sinara-hw/DiPho/README.md

# DiPho

Digital photodiode with USB and Ethernet interfaces

## Design Files

Design files (schematics, PCB layouts, BOMs) can be found at [DiPho/Releases](https://github.com/sinara-hw/DiPho/releases).

## Wiki

More information can be found on the [wiki](https://github.com/sinara-hw/DiPho/wiki).
