sinara-hw/DiPho/DiPho_AFE/Project Outputs for DiPho_AFE/DiPho_AFE_BoM.xlsx

Designator | Quantity | Manufacturer Part Number | Comment | Footprint | Description
R13 | 1 | R0402_0R_JUMPER | 0 | RESC1005X40N | Resistor
R12 | 1 | R0402_324K_0.1%_0.063W_100PPM | 324k | RESC1005X40N | Resistor - 0.1%
R11 | 1 | R0402_32K4_0.1%_0.063W_25PPM | 32k4 | RESC1005X40N | Resistor - 0.1%
R10 | 1 | R0402_3K24_0.1%_0.0625W_100PPM | 3k24 | RESC1005X40N | Resistor - 0.1%
R9 | 1 | R0402_324R_0.1%_0.063W_100PPM | 324 | RESC1005X40N | Resistor - 0.1%
R8 | 1 | R0402_2K2_1%_0.0625W_100PPM | 2k2 | RESC1005X40N | Resistor - 1%
R7 | 1 | R0402_10K2_1%_0.0625W_100PPM | 10k2 | RESC1005X40N | Resistor - 1%
R6, R14 | 2 | R0402_10K_1%_0.0625W_100PPM | 10k | RESC1005X40N | Resistor - 1%
R5 | 1 | R0402_1K_1%_0.0625W_100PPM | 1k | RESC1005X40N | Resistor - 1%
R2, R4 | 2 | R0402_470R_1%_0.0625W_100PPM | 470 | RESC1005X40N | Resistor - 1%
R1, R3, R17, R18, R19 | 5 | R0402_10K_0.1%_0.063W_25PPM | 10k | RESC1005X35N | Resistor - 0.1%
L2 | 1 | BLM15HD601SN1D | 600R@100MHz | INDC1005X55N | Ferrite Bead
J1 | 1 | 52465-1671 | 52465-1671 | 524651671 | A Connector for Board - Board Connections with A 0.80 mm Pitch. (Molex)
IC8 | 1 | AD8541ARTZ-REEL7 | AD8541ARTZ-REEL7 | ADI-RJ-5_N | Single Channel RRIO Operational Amplifier, 1 MHz BW, 920 mV/us SR, Industrial, 5-pin SOT23 (RJ-5), Reel
IC6 | 1 | MAX4639EUE+T | MAX4639EUE+T | TSOP65P640X110-16L | MAX4639 Series SP4T 2.5V 3.5 Ohm Surface Mount Analog Switch - TSSOP-16
IC4 | 1 | AT24MAC402-MAHM-T | AT24MAC402-MAHM-T | FP-C04-21355-Q4B-MFG | IC EEPROM 2K I2C 1MHZ 8UDFN
IC3 | 1 | BD00HC5WEFJ-E2 | BD00HC5WEFJ-E2 | TSOP127P600X100_HS-9L | LDO Regulator Pos 0.8V to 4.5V 1.5A 8-Pin HTSOP-J EP T/R
IC1, IC2 | 2 | TLV9002SIRUGR | TLV9002SIRUGR | QFN50P150X200X40-10N | Rail-to-Rail Input/Output Operational Amplifier Dual 1.8V to 5.5V 10-Pin X2QFN T/R
D3 | 1 | VBPW34S | VBPW34S | SOT0P705X130-2M | IR-photodiode Photoelectric current: 45...55 uA Wavelength of max. photosensitivity: 940 nm
CLIP1, CLIP2, CLIP3, CLIP4 | 4 | S1721-46 | Clip 1 Pin | MSBOX_HARWIN_S1721-46 | Surface Mount Clip for PCB Screening Covers
C14 | 1 | CC0402_47PF_50V_5%_C0G | 47pF | CAPC1005X55N | Non-polarised capacitor
C13 | 1 | CC0402_470PF_50V_10%_X7R | 470pF | CAPC1005X55N | Non-polarised capacitor
C12 | 1 | CC0402_4.7NF_16V_10%_X7R | 4.7nF | CAPC1005X55N | Non-polarised capacitor
C11 | 1 | CC0402_47NF_25V_10%_X7R | 47nF | CAPC1005X55N | Non-polarised capacitor
C10, C16 | 2 | CC0603_4.7UF_16V_10%_X5R | 4.7uF | CAPC1709X95N | Non-polarised capacitor
C7, C8 | 2 | CC0805_10UF_10V_10%_X7R | 10uF | CAPC2012X135N | Non-polarised capacitor
C4 | 1 | CC0402_1NF_50V_10%_X7R | 1nF | CAPC1005X55N | Non-polarised capacitor
C3, C5, C6, C15, C17, C18 | 6 | CC0402_100NF_16V_10%_X7R | 100nF | CAPC1005X55N | Non-polarised capacitor
C2 | 1 | CC0402_680NF_10V_10%_X5R | 680nF | CAPC1005X55N | Non-polarised capacitor
C1 | 1 | CC0402_10NF_16V_10%_X7R | 10nF | CAPC1005X55N | Non-polarised capacitor
