sinara-hw/DiPho/DiPho_digital/Project Outputs for DiPho_digital/DiPho_digital_BoM.xlsx

Designator | Manufacturer Part Number | Quantity | Footprint | Comment | Description
C1, C11 | CC0402_10NF_16V_10%_X7R | 2 | CAPC1005X55N | 10nF | Non-polarised capacitor
C2, C3, C4, C13, C14, C15, C18, C19, C23, C26, C27 | CC0402_100NF_16V_10%_X7R | 11 | CAPC1005X55N | 100nF | Non-polarised capacitor
C5, C6 | CC0603_1UF_16V_10%_X7R | 2 | CAPC1608X87N | 1uF | Non-polarised capacitor
C7, C8, C9, C12 | CC0603_4.7UF_16V_10%_X5R | 4 | CAPC1709X95N | 4.7uF | Non-polarised capacitor
C10 | CC0402_1UF_16V_10%_X5R | 1 | CAPC1005X55N | 1uF | Non-polarised capacitor
C16 | CC0603_10UF_10V_10%_X5R | 1 | CAPC1608X80N | 10uF | Non-polarised capacitor
C17 | GRM21BR6YA106KE43 | 1 | CAPC2012X145N | 10uF | Non-polarised capacitor
C20, C21 | CC0805_220NF_100V_10%_X7R | 2 | CAPC2012X135N | 220nF | Non-polarised capacitor
C22, C24, C25 | CC0402_2.2UF_16V_10% | 3 | CAPC1005X55N | 2.2uF | Non-polarised capacitor
D1 | BZX84C7V5 | 1 | SOT95P240X130-3N | BZX84C7V5 | Diode Zener Anode Pin 1 Cathode Pin 3 (Pas de pin 2)
D2 | BAT54HT1G | 1 | SOD2513X100N | BAT54HT1G | Schottky Diode
D3 | DRTR5V0U4S-7 | 1 | SOT65P210X110-6N | DRTR5V0U4S-7 | Integrated Quad Ultra-Low Capacitance ESD Protection
D4, D5 | ESD7241N2T5G | 2 | DFN65P100X40-2N | ESD7241N2T5G | Ultra-Low Capacitance ESD Protection Ultra-Low Capacitance ESD Protection
IC1 | STM32F103T8U6 | 1 | STM-VFQFPN36_L | STM32F103T8U6 | ARM Cortex-M3 32-bit MCU, 64 KB Flash, 20 KB Internal RAM, 26 I/Os, 36-pin VFQFPN, -40 to 85 degC, Tray
IC2 | MCP47CMB02-E/MG | 1 | QFN127P600-8N | MCP47CMB02-E/MG | DAC 2-CH Resistor-String 8-bit 16-Pin QFN EP Tube
IC3 | TLV76750DRVR | 1 | SON65P200X80_HS-7N | TLV76750DRVR | Precision Linear Voltage Regulator Positive 5V 1A 6-Pin WSON T/R
IC4 | NCP115ASN330T2G | 1 | SOT95P275X110-5N | NCP115ASN330T2G | LDO Regulator, 300 mA, Low Iq, High PSRR, High Accuracy 3.3V, TSOP5, Active Discharge, Normal Vout Slew-Rate
IC5 | NCN26010XMNTXG | 1 | QFN40P400X400X100_HS-33N | NCN26010XMNTXG | Ethernet Controller, 10 Mb/s, Single-Pair, MAC + PHY, 802.3cg, 10BASE−T1S Compliant
J1 | 0733660062 | 1 | 73366-0062 | 0733660062 | Conn MCX F 50Ohm Solder ST Thru-Hole Gold T/R
J2 | 5022370517 | 1 | 502237-0517 | 5022370517 | Conn Mini USB Type B RCP 5 POS 0.8mm Solder ST Thru-Hole 5 Terminal 1 Port USB 2.0 Tray
J3 | 53307-1671 | 1 | 533071671 | 53307-1671 | 0.80mm Pitch Header Surface Mount Dual Row Vertical Stacking 4.50 and 5.50mm Stacking Heights 16 Circuits
L1, L2 | BLM15HD601SN1D | 2 | INDC1005X55N | 600R@100MHz | Ferrite Bead
L3 | DLW21SN900SQ2L | 1 | IND_MURATA_DLW21S | 90R@100MHz | Inductor Common Mode
L4 | LPD5030-154MRC | 1 | IND_COILCRAFT_LPD5030 | 150uH | Inductor Common Mode
L5 | DLW32MH201XK2L | 1 | FP-DLW32MH201XK2L-MFG | DLW32MH201XK2L | 200UH-20%/+50% (AT 0.1MHZ)70MA R
L6 | 74279266 | 1 | INDC1608X100N | 1k@100MHz | Ferrite Bead
LD1 | LTST-C193KGKT-5A | 1 | LED_LITEON_LTST-C193KGKT-5A | Green | LED Green 1C 2A
LD2 | LTST-C193KSKT-5A | 1 | LED_LITEON_LTST-C193KSKT-5A | Yellow | LED Yellow 1C 2A
OSC1 | ASE-8.000MHZ-E-T | 1 | OSC_ABRACON_ASE | 8MHz | Oscillator 4 pins 1=STBY 2=GND 3=OUT 4=VDD
OSC2 | ASE-25.000MHZ-LR-T | 1 | OSC_ABRACON_ASE | 25MHz | Oscillator 4 pins 1=STBY 2=GND 3=OUT 4=VDD
P1 | 691347000002B | 1 | 691347000002B | 691347000002B | WR-TBL Series 3470B PCB Header Vertical cable entry, THT, pitch 2.5mm, 2p
R1, R2 | R0402_4K7_1%_0.0625W_100PPM | 2 | RESC1005X40N | 4k7 | Resistor - 1%
R3, R4, R5 | R0402_100K_1%_0.0625W_100PPM | 3 | RESC1005X40N | 100k | Resistor - 1%
R6, R7 | R0402_1K5_1%_0.0625W_100PPM | 2 | RESC1005X40N | 1k5 | Resistor - 1%
R8 | R0402_10K_1%_0.0625W_100PPM | 1 | RESC1005X40N | 10k | Resistor - 1%
R9 | R0603_3K3_1%_0.1W_100PPM | 1 | RESC1608X55N | 3k3 | Resistor - 1%
R10, R11 | MCU0805PD4999DP500 | 2 | RESC2012X60N | 49R9 | Resistor - 0.1%
R12 | R0402_3K3_1%_0.0625W_100PPM | 1 | RESC1005X40N | 3k3 | Resistor - 1%
R13 | R0402_2K_1%_0.0625W_100PPM | 1 | RESC1005X40N | 2k | Resistor - 1%
SW1 | 450301014042 | 1 | 450301014042 | 450301014042 | WS-SLTV THT Mini Slide Switch, Opposite Side Connection, SPDT, 12VDC, 500mA, 800g
T1 | DMP2066LSN-7 | 1 | SOT95P285X140-3N | DMP2066LSN-7 | P-CHANNEL MOSFET WITH DIODE
TP3 | S2761-46R | 1 | S2761-46R | S2761-46R | Conn Terminal Post 1 POS Solder ST SMD 1 Port T/R
