sinara-hw/DiPho/(threads)

Thread 1 (2020-05-06):

[RFC] Digital monitoring photodiodes

airwoodix, 2020-05-06:
Continuing the discussion in sinara-hw/meta#52 ([comment](https://github.com/sinara-hw/meta/issues/52#issuecomment-624352053)) on cheap monitoring photodiodes for Sinara.

  - Something like Thorlabs [S120C](https://www.thorlabs.com/thorproduct.cfm?partnumber=S120C)
  - **form factor**: max 1"-ish diameter, 20 mm deep (see Thorlabs link above)
  - **photodetector**: Si photodiode, area > 2x2 mm², e.g. [BPW34](https://www.vishay.com/docs/81521/bpw34.pdf)
  - **bandwidth**: tens of Hz to few kHz, more not relevant
  - **photocurrent**: 10 µA to 10 mA
  - **gain**: if possible linear, selectable in decades, if not, log amplifier
  - **interface**: digital, SPI-like, ideally single cable for power and data to logging board in Sinara crate. RJ45 is too bulky, USB-C sounds cool but doesn't lock
  - **cable length**: around 2 meters would be convenient

Does this cover enough use cases?

I only see opportunities if this can be around 10 times cheaper than the Thorlabs product, so max 50 €/$ per channel.

gkasprow, 2021-02-10:
@jordens do you have the mechanical files for your SM1 design?

jordens, 2021-02-10:
[logpd.gerber.zip](https://github.com/sinara-hw/DiPho/files/5960682/logpd.gerber.zip)
[logpd.view.pdf](https://github.com/sinara-hw/DiPho/files/5960683/logpd.view.pdf)
[logpd.sch.pdf](https://github.com/sinara-hw/DiPho/files/5960684/logpd.sch.pdf)

pm-daniel, 2021-02-15:
Hi, I'm a student who will be doing that project. I'd prefer sticking to the STM32 platform as an MCU cause I've far more experience working on them rather than ESP32 or other platforms. If there is a necessity for that sensor to have wireless communication of some flavor then I would opt for STM32 + wifi/bt module. As far as wired communication goes, I understand that there should be an M8 connector (ethernet, MQTT protocol) and USB-C for console (configuration/setup?; straight forward TX/RX pair or USB VCP?). What about RS-485? Are we ditching that idea? In terms of mechanical design, I understand that project should fit on two circular PCB's (~24mm dia) - am I right ? Are there any other things that I should take into consideration?

gkasprow, 2021-02-19:
Once we have the Ethernet, RS485 makes not much sense.
Yes, we can use USB VCP. The design should be cheap, so before we freeze some decision, the budget must be made.
The design should fit in the enclosure. Since we want analog output, it would be probably easier to use two rectangular boards.

gkasprow, 2021-02-19:
We could use a low-cost CPU like STM32F072CBU6 which has a USB and the package is tiny.

dhslichter, 2021-02-19:
not sure why analog output means that rectangular boards are better?  The point of circular boards is to make it possible to fit them inside a 1" lens tube for the photodiode application -- this makes the mounting mechanics simple and easy.

gkasprow, 2021-02-19:
You have to somehow expose the coax connector. It can of course protrude through the rear digital board, but it occupies some space. If we place the board along the sensor axis we have access to rear connectors but have issues with sensor fixing (must use THT) and smaller board area.
Anyway, after the selection of enclosure and connectors and initial placement, we need to make some mockups to see what fits and what doesn't.

gkasprow, 2021-02-19:
I did a quick mockup. It looks like we can easily fit the entire functionality on a single PCB. M8 connectors are far too big. But we can use a USB-C connector. It has normally unused high-speed lanes that can be adapted for Ethernet.
In such a way if we connect it to a standard USB hub, the circuit will enumerate as a serial port of whatever we implement and will be supplied over USB
If we plug it into a dummy 5V power injector, using either USBC-RJ45 cable or a dedicated passive adapter, it will work as an MQTT client. We can even skip the LAN transformer because we don't need isolation. It will always be one on the switch side.
Here are some mockups
version with LAN trafo
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

Thormalbs S120C-like enclosure
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

ADC, Logamp, diode, STM32, ENC424J600 PHY
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

If we want to add analog output, there are problems with such high SMA connectors - I found only one (AMP 132291) that fits somehow.
If we skip the LAN trafo, we can fit the SMA connector. There are also super-small LAN [trafos avaialble](https://product.tdk.com/info/en/catalog/datasheets/090007/trans_alt_en.pdf)
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

and the possible final effect
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

gkasprow, 2021-02-19:
Of course, we can make a dedicated sensor board, but the supply and SMA would have to go from the rear board. SMA can also protrude through the digital board, but the analog board would need another connector with a cable for the power supply. It's easier to leave the SMA and USB on the digital board and if someone wants a cheap solution, simply don't mount the CPU, LAN PHY, and ADC and treat the digital board as power delivery.
To connect the two boards one can use 1.27mm gold pin connectors or i.e. Molex SlimStack™ B2B connectors.

gkasprow, 2021-02-19:
@pm-daniel
the PHY circuit is here https://github.com/sinara-hw/Booster/tree/master/PCB/Booster_User_Interface_ENC424J600
the CPU is here https://github.com/elhep/SiPM_AFE
I published initial files to the repo. This will give you a kick-start.

gkasprow, 2021-02-20:
The wireless connectivity can be easily provided using RPI0 and USB cable.

gkasprow, 2021-02-20:
two-board version
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

gkasprow, 2021-02-20:
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

gkasprow, 2021-02-20:
Do we need more than 12Bit ADC? If not, then one from STM32 can be used. We also have two 12b-bit DACs that can be used for offset correction.

pm-daniel, 2021-02-20:
the two-board design seems more versatile and should be easier to design. If we decide to go with two boards then we should be able to fit M8 connector which footprint is actually smaller than the footprint of SMA connector (12.5x10mm vs 13x13mm). In my mind another benefit of the two-board design is better separation between analog and digital sections, am I right?

jordens, 2021-02-20:
12 Bit is plenty.

gkasprow, 2021-02-20:
M8 is much bigger than SMA. here is the comparison
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

gkasprow, 2021-02-20:
USB is free, for M8 you have to pay.

gkasprow, 2021-02-20:
We have 50$ budget including mechanics and assembly. M8 is 15$ or so.

gkasprow, 2021-02-20:
And we can make a simple USBC to RJ45 adapter placed in a more convenient place if somebody doesn't want to make a cable. Such an adapter would fan out the USBC to USBC for supply/USB and RJ45 for Ethernet. That would be super-cheap.

gkasprow, 2021-02-20:
we can try to use TL061 opamp - they are super-cheap. The offset can be canceled using MCU DAC. We don't need external ADC so we can make it very simple from an HW point of view. Gain can be switched using a low-cost 4051mux. All gain corrections would be made in SW. You can also find a lower-cost B2B connector.

gkasprow, 2021-02-20:
USB-C cable can be built in a few minutes using a piece of RJ45 patchcord and the plug
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

gkasprow, 2021-02-20:
the KSZ8851 MAC+PHY over SPI has Auto-MDIX so we don't care about Ethernal Rx/Tx pair swapping

gkasprow, 2021-02-20:
Since we have a dedicated AFE board, let's place both TIA and log amp and use the assembly option to connect one or another to the photodiode. We have enough ADC inputs to connect both outputs.

gkasprow, 2021-02-20:
KSZ8851 is also much smaller than the ENC chip, so we have more place on the digital board. This particular MCU has also a CAN controller but I'm not sure if it's worth it to place a 0.5$ transceiver and use the remaining USB-C pins for such connectivity.

pm-daniel, 2021-02-20:
fair point about M8 being larger than SMA - I forgot about that bulky mechanical part of the connector and made that statement based on the inner part drawing only:
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

gkasprow, 2021-02-20:
[Here](https://www.analog.com/en/analog-dialogue/articles/programmable-gain-transimpedance-amplifiers.html) is an article on making the programmable gain TIA.

gkasprow, 2021-02-20:
And some hints on TIA optimization:
https://www.analog.com/en/technical-articles/optimizing-precision-photodiode-sensor-circuit-design.html

pm-daniel, 2021-02-20:
thanks, looks like I have some "homework" to do

pm-daniel, 2021-02-28:
I've created the first version of a simple block diagram for DiPho
[DiPho_block_diagram.pdf](https://github.com/sinara-hw/DiPho/files/6057235/DiPho_block_diagram.pdf)

gkasprow, 2021-03-14:
@pm-daniel
- STM32G4 is nearly 2x more expensive and overkill for this application. For differential ADC, you need a differential driver. It may be not worth the circuit complication. The TIA will be spaced by 1..2cm from ADC, I don't see a clear advantage of differential signalling here.
- I'd avoid any DC/DC converters here, especially PoE flyback converters as they are bulky and it's difficult to filter EMI they crate.
- PoE can be entirely passive. Active one can be without isolation but would create ground loop issues. Isolated one is bulky.
- I would use transformer-less Ethernet and make a power supply injector as a tiny PCB with USB-C (DiPho), USB-C(power brick) and RJ45. One can make one with USB-C, RJ45 and proper isolated PoE  and use when needed. In this way we have 3 usage scenarios - first with cheap USB-C to RJ45 cable. Supply can be delivered using cheap POE injector or directly from the power suply. More elegant solution is an adapter where you plug the USB charger and RJ45 cable. Third one is 802.11af compliant power solution.  The advantage is that the basic configuration is simple and cheap but requires custom cable which can be easily made by soldering USB-C and RJ45 cables.

gkasprow, 2021-03-14:
@pm-daniel when can I expect the first version of schematics?

pm-daniel, 2021-03-15:
@gkasprow
- ok, then I will use STM32F072C8U and skip adc diff driver step.
- I like the approach with custom cable with tiny PCB - it basically means that we can provide power to DiPho via USB power lines, so what's the point in using PoE? Maybe I misunderstood something?
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
- I will try to finish a schematic draft by the end of march

pm-daniel, 2021-03-15:
But are there any standardized voltage/current values for passive PoE? I found some info about 24V/48V but it seems pretty high with no DC/DC converter onboard...

gkasprow, 2021-03-15:
Passive PoE is always custom. There is no standard behind it. People are using usually 12V but there are also 5V versions. You simply use free RJ45 lines or transformer taps to transfer DC. Some are using the bridge rectifiers to make it slightly more robust.
In our case we have a way to supply 5V via USB, so let's add a proper PoE converter to the adapter PCB. If someone needs PoE, will simply install such a converter. We are using Silvertel converters, but there are also lower-cost ones used in Arduino clones.

gkasprow, 2021-03-15:
The only difference between standard PoE and passive PoE is the lack of a power negotiation mechanism. Voltage is a secondary thing, standard PoE modules can sometimes work with voltages down to 12V, but it is usually 48V.

pm-daniel, 2021-03-15:
Ok. Thanks for that clarification.
By proper PoE converter on that adapter PCB you mean Active PoE compatible with 802.3af/at or just DC/DC converter with max Vin >=48V?
And as I understand, power would run from the adapter PCB to DiPho via VCC/GND pins on USB-C connectors, because PoE conversion will happen on the adapter PCB. But then eth transformer should also be located on that adapter PCB, am I right?
So in the end adapter PCB, will have similar functionality (+external power input) to this PoE splitter, but RJ45 and USB cables will be merged into one cable?
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

gkasprow, 2021-03-15:
Yes, I mean using for exampel Silvertel converter + RJ45 connector. Look how it is done in Thermostat design.

pm-daniel, 2021-03-31:
@gkasprow I've just pushed the first revision/draft schematics of afe and mcu boards.

gkasprow, 2021-04-30:
@pm-daniel please use the master branch. My files were just templates.
Did you do some simulations of the AFE?
Why this particular opamp was used?

gkasprow, 2021-04-30:
It's a bad idea to use both SSTX pairs for Ethernet signals - you will get stubs. That's why we use Auto MIDIX to enable automatic pair detection. Just use SSTX 1 and SSTX2.

gkasprow, 2021-04-30:
try to use a standard SWD connector, of course, if that fits

gkasprow, 2021-04-30:
please use ports only for multi-page projects. for local signals use nets. See how other Sinara projects are organized

pm-daniel, 2021-05-07:
> @pm-daniel please use the master branch. My files were just templates.
Of course - I pushed to the default git branch (which now happens to be "main" instead of master), I will rearrange it and push the next commits to "master"
> Did you do some simulations of the AFE?
Not yet, If I manage I will do some simulations this weekend. I understand that I should use the current source as a stimulus?
> Why this particular opamp was used?
I choose OPA141 because it has significantly smaller input noise and input bias current, is available in a smaller package than TL071 f.e. and its price is not horrible IMO.

pm-daniel, 2021-05-07:
> try to use a standard SWD connector, of course, if that fits

I'll try to fit it

gkasprow, 2021-05-09:
Just make sure the file you push is listed on Github.

 >I understand that I should use the current source as a stimulus?

yes, but please add photodiode mode.

>I choose OPA141 because it has significantly smaller input noise and input bias current, is available in a smaller package than TL071 f.e. and its price is not horrible IMO.

right. But in our case, you have to prove you need low voltage input noise. We are working with high-value feedback resistor so the current noise may be dominating.  Low input bias current is not that critical since you can easily compensate for it. But be careful because you can add some noise! Here is an [online tool ](https://www.jensign.com//transimpedanceamp/index.html)to play with TIA. Essentially, you have to show that you know what you are doing :)

pm-daniel, 2021-05-14:
@gkasprow sure.
It's a busy time right now but I'll try to do some simulations (and documents) in the following week or two

pm-daniel, 2021-06-06:
@gkasprow After doing a few simulations it became obvious that OPA141 may not be the best pick (TL071 either). Because of the pretty bad output voltage swing characteristic - I totally forget about it (for TL071 it's +-1.5V from the supply voltage and +-0.3V from the supply voltage for OPA14). I've tried a few different opamps (AD8541, AD8539, ADA4891) and ADA4891 looks most promising and it has a very low input bias current, very good swing characteristic, and a similar price to OPA141. All those conclusions are based on transient simulations that I conducted in LTspice.
I used the current source with parallel capacitance as stimulus and now I'm struggling with noise simulation as it looks like LTspice expects voltage source to be selected as a noise source. Is there a better way of simulating photodiode input in the LTspice? I've spent some time on research and it looks like everyone uses just the current source with capacitance (just like I did).
Once I complete the noise and bandwidth simulation I will publish results on GitHub. Maybe you have any other recommendations regarding opamp choice?

dnadlinger, 2021-06-06:
A command like `.noise V(OUT) I1 dec 1000 10 10Meg` (where OUT is the output node, and I1 is the current source) should work fine in LTspice.

pm-daniel, 2021-06-06:
@dnadlinger thank you! After seeing your reply I've checked my simulation command again and it turns out that I had IN and OUT nodes defined in the wrong order. It works just fine now.

gkasprow, 2021-08-17:
@pm-daniel can you open a new issue and post your noise simulations?

airwoodix, 2022-07-14:
@pm-daniel Do you have an update on this project? How did the testing of the first boards go? Thanks!

pm-daniel, 2022-07-14:
@airwoodix Tests are not finished yet - they will be ready by the end of the month. I'll publish the results on GitHub. Sorry for the delays but in the meantime, I'm writing my BEng thesis. Working a full-time job at Creotech (on non-related projects) also doesn't help. I hope you understand!

airwoodix, 2022-07-14:
Of course! :slightly_smiling_face: Thanks a lot for the update. I'm looking forward to the testing results.

gkasprow, 2022-07-26:
@pm-daniel can you post some photos of the PCBs?

pm-daniel, 2022-07-29:
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

It's mounted in measurement fixture for now so those are the best photos I can take at the moment

I'll upload better ones if needed after finishing the measurements

Thread 2 (2021-02-18):

[RFC] Other front end boards

dtcallcock, 2021-02-18:
Right now it looks like DiPho will be a two board device, with one board having the photodiode + amp, and one board having the DAC, uC, power, and communications.  It has already been mentioned that different versions of the photodiode board could be produced in the future (eg. with log amp). One could imagine a much broader range of applications though (eg. analog front end for voltage monitoring/logging, environmental monitors).  I mention it now as, if this is thought to be a good idea, it may influence exactly how things are divided between the two boards and what kind of header should go between them.

dtcallcock, 2021-02-18:
Rf power meter + frequency counter is another idea.

gkasprow, 2021-02-18:
true, it could be a laser driver, humidity sensor,  single channel Sampler, optical power meter, etc. I would expose all pins we have

dhslichter, 2021-02-19:
is this too much mission creep?  there are a million little commodity IoT widgets out there.  I don't think it hurts to expose all available pins, but maybe better to focus on making this a good photodiode monitor first?

dtcallcock, 2021-02-19:
> better to focus on making this a good photodiode monitor first?

I'd argue that the photodiode aspect of this project is trivial.  The 'IoT widget' aspect seems to be the tricky part and thus I think we should consider leveraging effort put in there.

> is this too much mission creep?

I think this issue is more about keeping this in mind and not doing anything to preclude it unless there is good reason, rather than creeping the mission.

dhslichter, 2021-02-19:
> I'd argue that the photodiode aspect of this project is trivial.

Agreed.

> I think this issue is more about keeping this in mind and not doing anything to preclude it unless there is good reason, rather than creeping the mission.

Fair.  Just wanted to raise the point.  It's already starting to look like the all-singing, all-dancing IoT widget with 4 different communication protocols and 3 connectors and power harvesting and....

Thread 3 (2021-08-22):

[RFC] TIA Simulations

pm-daniel, 2021-08-22:
@gkasprow finally I've managed to finish TIA simulations (attached pdf file)  for several different opamp types. As that's my first time doing noise (and TIA in general) simulations in LTSpice there could be some errors that I'm not aware of.

[DiPho_TIA_Simulations.pdf](https://github.com/sinara-hw/DiPho/files/7027212/DiPho_TIA_Simulations.pdf)

gkasprow, 2021-08-22:
There is something wrong with TL071 and OPA141. Did you apply proper voltage? Can you post schematic?
When designing TIA, one should balance current noise and voltage noise contribution to the noise budget.
Did you do the noise budget?

pm-daniel, 2021-08-22:
Regarding voltage, I applied a 5V single-rail and it turns out to be sufficient for all tested opamps but TL071 which needs min 7V (but we have max 5V on the AFE board). Then it's no surprise that the results for TL071 are wrong. In the case of OPA141, I checked once again and the voltage should be sufficient, and I tested all opamps in the same schematic.  In my simulation, I've selected the current source as input, so I reckon that voltage noise is not taken into account, am I right? In that case what additional simulations I should make?

Here is the schematic I used for simulations:
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

Closed 2022-12-05.

Thread 5 (2021-10-17):

[sch rev] [digital] GND and chassis separation

filipswit, 2021-10-17:
For now both grounds are connected together, while you want to split them please use separate names for them.

Thread 6 (2021-10-17):

[sch rev] [digital] missing pu resistors

filipswit, 2021-10-17:
Missing pu resistors for:

- NRST
- MISO, 4k7 is recommend

Thread 7 (2021-10-17):

[sch rev] [digital] B2B connector

filipswit, 2021-10-17:
On digital board I2C interface is missing.

Thread 10 (2021-11-20):

PCB review

gkasprow, 2021-11-20:
Digital board
- [x] doesn't this particular STM MCU require crystal for USB operation?
- [x] Use L1, D1 the same as in other Sinara project (Stabilizer, Thermostat)
- [x] please add 10k pullup to NRST. I'm not sure C4 is good idea, it may interfere with debugger. If such one is on the devkit than it's fine.
- [x] Is C31 sufficient for this LDO?
- [x] use 1mm/0.15mm silkscreen, enable only active components. there is usually no place for all RCs
- [x] missing board shape on Mechanical1
- [x] #11
- [x] #15
- [x] add board name, version and date
- [x] when using ports, use hierarchical designs. It's easier to navigate through it.
- [x] in Sinara ecosystem we use IC? designators for chips
- [x] #12
- [x] name the board: DiPho_digital.PcbDoc
- [x] verify how the board will be fixed in the ALU enclosure, it may need some cutouts / key or copper clearance areas
- [x] expose some free IOs as testpoints. 1mm pads would be fine, try to expose UART

Analog board
- [x] use 1mm/0.15mm silkscreen, enable only active components. there is usually no place for all RCs
- [x] missing board shape on Mechanical1
- [x] add board name, version and date
- [x] unify stackup with digital board, we will produce all boards as one.
- [x] use ground plane
- [x] add current limiting resistor between 5V supplied opamp and MCU. Beware of latchups. 470Ohm and 10nF should do the job.  CPU ADC requires low impedance driver, that's why we need a capacitor. U5, U6 are affected
- [x] add some RC filter between MCU DAC and opamp buffer
- [x] #14
- [x] in Sinara ecosystem we use IC? designators for chips
- [x] use lowpass filter for AFE P5V0 rail. For the moment it's the same as USB rail. Maybe it makes sense to use LDO and let's say 4.7V rail voltage? ADL5304 works from 4.5V
- [x] name the board: DiPho_AFE.PcbDoc
- [x]  verify how the board will be fixed in the ALU enclosure, it may need some cutouts / key or copper clearance areas

Adapter
- [x] move USB to the board edge
- [x] adapt PCB shape to some existing and available enclosure, preferably [one with panels.](https://www.kradex.com.pl/product/obudowy_specjalne_inne_z_miejscem_pod_wyswietlacz/z67?lang=pl) Such panels can be easily cut with laser ploter.
- [x] add a PCB placeholder for EMI filter (fig 19 in datasheet)
- [x] use RA LED close to panel, preferably same as in other designs
- [x] why two LEDs are used?
- [x] add another supply connector, preferably USB so it would be possible to use Ethernet without PoE
- [x] add 5V 600W TVS
- [x] instead of D1 use the same diodes as in Thermostat.
- [x] use 1mm/0.15mm silkscreen, enable only active components. there is usually no place for all RCs
- [x] missing board shape on Mechanical1
- [x] add board name, version and date
- [x] unify stackup with digital board, we will produce all boards as one.
- [x] in Sinara ecosystem we use IC? designators for chips
- [x] PCB file is not added to the PrjPCB
- [x] name the board: DiPho_PoE_adapter.PcbDoc
- [x]  verify how the board will be fixed in the enclosure, it may need some holes / cutouts / key or copper clearance areas

Common
- [x] make separate common, multi-board project so all boards could be produced and assembled as one PCB, greatly reducing tooling cost. It's tricky so ask first.
- [x] one can use 0.2/0.5mm vias and 5mils/5mils traces/clearance
- [x] use[ TSK stackup](https://technosystem.pl/obwody-sztywne/)

gkasprow, 2021-11-20:
@pm-daniel I finished the review.

gkasprow, 2021-11-20:
- [ ] avoid via in the pad, add Altium rule.
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
- [ ] some components are too close. Try to use Mechanical 15 rectangles as a clearance marker
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
- [ ] tent vias, but only ones that are not exposed on the thermal pads.

pm-daniel, 2021-11-27:
@gkasprow I fixed all mentioned things in the adapter project 077a311

pm-daniel, 2021-11-29:
@gkasprow fixed a few things in the digital board schematic, have a look a5d5d1f

gkasprow, 2021-12-11:
@pm-daniel go on with the PCB design

pm-daniel, 2021-12-16:
@gkasprow I've finished AFE PCB f7f5641

gkasprow, 2021-12-17:
ok, looks good, but there are still a few issues
- [ ] Avoid such traces. They confuse the AOI
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

Use these instead
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

- [ ] Add and use acute angle rule
- [ ] there are still many DRC issues; add thermal pads to be allowed for vias
- [ ] digital PCB has many missing connections.

gkasprow, 2021-12-17:
and please mark all the issues above when fixed

pm-daniel, 2021-12-18:
@gkasprow both boards are finished 3fac3f8 26e2a46

gkasprow, 2021-12-18:
oh, I looked at the wrong releases.

pm-daniel, 2021-12-18:
not really, I've pushed them today ;)

pm-daniel, 2022-01-03:
@gkasprow Is there anything else to be fixed?

gkasprow, 2022-01-09:
It looks fine. we can produce prototypes.

pm-daniel, 2022-01-09:
Do I have to prepare production files?

gkasprow, 2022-01-09:
Yes, send them to Technoservice (TSK), and send me an invoice.

airwoodix, 2022-01-17:
@gkasprow @pm-daniel thanks a lot for the great work on this project! Is there already a timeline available for prototypes and firmware development?

pm-daniel, 2022-01-17:
@airwoodix the prototype was sent into production last week

airwoodix, 2022-01-17:
Awesome, thanks for the quick update! Could you please also upload the schematics' PDF as release? or is it too early for that?

gkasprow, 2022-01-17:
@pm-daniel please make a release as in other projects.

pm-daniel, 2022-01-18:
@airwoodix is there any way in which I can contact you? I would be grateful for some information about use cases for iPhone, it would help write my thesis introduction.

airwoodix, 2022-01-21:
Sure. I believe that my email is available from some (recent) commits in m-labs/artiq.

I don't have a specific application in mind at this stage. The motivation for #1 was to see if one can get small footprint general purpose photodiodes to drop in a laser system and record for a more or less extended period of time ("I see some weird periodic signal on my atoms/ions, can I correlate this to laser power?", "I need to couple a fiber that extends to the neighboring building" (current solutions include a return signal cable or a webcam / your-favorite-messenger video call), "I'd like an automatic alert when this laser diode dies, this fiber/cavity coupling gets bad, etc."). One can surely do fancier things depending on the actual bandwidth and dynamic range. The analog output could be used for feedback, as [mentioned](https://github.com/sinara-hw/DiPho/issues/1#issuecomment-772990559) by @dhslichter for example.

IIRC there's a bit more in #1. Overall, I find @jordens' [vision](https://github.com/sinara-hw/DiPho/issues/1#issuecomment-625387512) really attractive and DiPho looks like a nice step in this direction.

airwoodix, 2022-01-28:
@pm-daniel do you have an update on the PDF release? Thanks!

pm-daniel, 2022-01-28:
@airwoodix It will be ready by Monday - I had a really busy week.

pm-daniel, 2022-01-30:
@airwoodix pdfs are ready, there should be pre-release tag visible in repository

airwoodix, 2022-01-31:
@pm-daniel Wonderful, thanks a lot!

Closed 2022-03-06.

Thread 11 (2021-11-20):

wouldn't it be better to use SPI bus between MCU and Ethernet chip? TCP/IP stacks usually use such interface because it works with DMA.  This STM can't expose internal parallel data (EMIF) bus via IO pins. This means that each IO transfer would have to be done in SW which will add a lot of overhead. Just look how stacks handle external Ethernet PHYs

pm-daniel, 2021-11-20:

pm-daniel, 2021-11-20:
@gkasprow I would use the SPI interface between PHY and MCU if one would be available, in the TQFP package KSZ has only a parallel interface - maybe we should go back to the QFN version and try to find one?

pm-daniel, 2021-11-27:
went back to QFN version

Closed 2021-11-27.

Thread 12 (2021-11-20):

check if the Ethernet connector with magnetics used in Stabilizer/Thermostat can be reused here

pm-daniel, 2021-11-20:

pm-daniel, 2021-11-20:
We use USB-C as io connector for ethernet comm

gkasprow, 2021-11-30:
I'm talking about the adapter board

pm-daniel, 2021-12-01:
I've used it there in latest revision

Closed 2021-12-01.

Thread 13 (2021-11-29):

isoSPI

jordens, 2021-11-29:
Another option for these things might be isoSPI (thanks to the TUBS guys for mentioning it).
This is isolated SPI over a single pair up to 1 Mb/s and 100 m that is very simple and compatible with extremely low power devices.
You could build an isolated digital photodiode (or DAC) that works with a battery for a couple years.
https://www.analog.com/media/en/technical-documentation/data-sheets/LTC6820.pdf

gkasprow, 2021-11-30:
Interesting. It wakes up itself when the master talks to it. In our case we would have to use some circuit that wakes up the ADC and the amplifier to save battery life.
It's too late to use it in this design (Piotr has to finish his thesis), moreover this chip is not available. we hardly managed to buy components for existing design.
We can later on design a dedicated digital board with such functionality. But we would need another master board with some standard interface. That would make sense in case we need a lot of isolated sensors. But in case of photodiodes, I'm not sure if we care about the isolation

Thread 14 (2021-12-01):

correct me if I'm wrong - the CAL_DIV_OUT signal is used to estimate U3 resistance?

pm-daniel, 2021-12-01:

pm-daniel, 2021-12-01:
@gkasprow that’s right

Closed 2021-12-11.

Thread 16 (2022-03-06):

DiPho_digital v1.0 issues

pm-daniel, 2022-03-06:
This issue is for tracking found mistakes/issues in DiPho_digital.PrjPcb
- [x] Missing P3V3 1k5 1% pull-up resistor on USB DP line (STM AN4879 page 4)

pm-daniel, 2022-03-06:
- [ ] Missing P3V3 1k5 1% pull-up resistor on USB DP line (STM AN4879 page 4)

pm-daniel, 2022-04-17:
2. - [ ] Add diagnostic ADC channels (f.e. 3V3, 4V7 voltage sense) in future revision

pm-daniel, 2022-09-19:
3. - [ ] Revise the ethernet circuitry

gkasprow, 2022-09-19:
- [ ] add passive PoDL circuit with reverse protection
- [ ] make two dedicated AFE boards?
- [ ] use low profile USB connector
- [ ] replace big SMA connector with small MCX connector and make room for twisted pair connector

pm-daniel, 2022-09-23:
- [ ] provide another point of support between PCBs apart from the mezzanine connector

Closed 2022-12-05.

Thread 17 (2022-03-27):

DiPho_AFE v1.0 issues

pm-daniel, 2022-03-27:
This issue is for tracking found mistakes/issues in DiPho_AFE.PrjPcb

1. - [x] Wrong resistor values in feedback divider of MCP1726 LDO (DS21936C page 14) - change to 11k5 and 120k respectively

pm-daniel, 2022-09-19:
2. - [ ] Change multiplexer IC to something with better leakage current characteristic, ex. Vishay DG4052E (50nA max) or Maxim MAX4052 (1nA - 50nA max, depending on version)
3. - [ ] Seperate the LOG amp and TIA version to two different PCBs.
4. - [ ] Fix the wrong connections of offset voltage in TIA circuit.

Closed 2022-12-05.

Thread 18 (2022-09-17):

DiPho v2 Ethernet implementation

gkasprow, 2022-09-17:
Existing Ethernet implementation (KSZ8851SNLI) lacks RUST support and MAC+PHY chip is unobtainable (2year lead time). It also requires external USB /Poe adapter when sb wants to use Ethernet. Piotr decided to not develop an Ethernet driver because at the time this chip was NRND.

Since typical use case requires several such sensors (@airwoodix ) in one setup, we need to adopt to such conditions.
For the moment I see several possible solutions

### 1. Keep it as it is and buy chips paying 20x more.

Pros
- no need of new HW design
- we keep existing USB-C based architecture

Cons
- need for SW development and maintainance of RUST driver
- not optimal architecture for multi-sensor Ethernet based network; we need several PoE-USBC adapters and Ethernet switch

### 2. Replace the SPI MAC+PHY with available and cheap [DM9051](https://www.dacomwest.de/en/?catid=15&view=article&id=207:dm9051-en).

Pros
- quick HW modification
- we keep existing USB-C based architecture

Cons
- need for SW development and maintainance of RUST driver
- not optimal architecture for multi-sensor Ethernet based network; we need several PoE-USBC adapters and Ethernet switch

### 3. Other SPI Ethernet options are also available - Lan9250 - package much bigger,

Pros
- we keep existing USB-C based architecture

Cons
- serious HW modification, possibly additional PCB if we want to preserve the sensor package
- need for SW development and maintainance of RUST driver
- not optimal architecture for multi-sensor Ethernet based network; we need several PoE-USBC adapters and Ethernet switch

### 4.  ENC424J600T - much bigget package, lack of Auto-MIDX

Pros

- no direction detection so we would have to use another connector, maybe RJ45 with embedded non-isolated PoE converter
- RUST driver support

Cons
- serious HW modification, possibly additional PCB if we want to preserve the sensor package
- not optimal architecture for multi-sensor Ethernet based network; requires PoE switch; we need several PoE-USBC adapters and Ethernet switch

**5. Replace CPU with embedded MAC one + external PHY**

Pros
- we keep existing USB-C based architecture
- RUST driver support

Cons
- serious HW modification, more layers to support BGA CPU package; possibly additional PCB if we want to preserve the sensor package

### 6. Replace CPU with embedded MAC one + external PHY supporting SPE
 [PHY](https://www.microchip.com/en-us/product/LAN8670) supporting [10Base-T1L single pair ethernet](
https://ethernetalliance.org/wp-content/uploads/2021/07/EA_TechBrief-SPE-SPoE_FINAL.pdf) is available from a few vendors. We already discussed with @jordens a year ago but chipset availability was poor. Now one can buy [cheap USB adapters](https://www.microchip.com/en-us/development-tool/EV08L38A)

Pros
- serious redesign of PCB
- scalable architecture - just route a pair of wires from SPE adapter to all sensors in the setup. The same pair delivers power.
- existing RUST driver support

Cons
- serious HW modification, more layers to support BGA CPU package; possibly additional PCB if we want to preserve the package
- design a new adapter which provides power supply to al sensors (easy); there is even such design on github

gkasprow, 2022-09-17:
if we decide to go for option 6 then:
KSZ8851SNLI-TR -> LAN8671B1-E/U3B  6.2$ -> 3.2$
STM32F103T8U6 -> STM32F107VCH6  (the only available STM32 with MAC) 7.3$ -> 12,7$
DAC MCP47CMB02-E/MG - none 1.09$
USB connector 632722110112 ->  pluggable twisted wire connector 691347000002B 3.6$ -> 0.9$
SMA 132291 -> MCX; we have to and can use lower connector  73415-1691 5.5$ -> 1.5$

total
23,69 -> 18,3

and we will fit.
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

we can also add optional mini-USB connector which is much smaller and cheaper than USB-C one
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

pm-daniel, 2022-09-17:
To me, the 6. approach is the most appealing. It uses fairly recent technology so supply of the ICs should be quite good in near future. My two cents would be:
1. the mentioned USB adapter does not support PoDL i.e. does not provide any power - so if one want to use an USB interface via an adapter there should be other way of powering the dipho or the custom adapter design supporting PoDL
2. from my experience I really dislike micro USB connectors. I find them to be really fragile and imho not suitable for lab instruments. I would use USB mini B connector preferably, as it's close in size and price but much more durable.
3. as there are no ICs for PoDL (or I couldn't find them quickly enough ;) ) I found a quite nice [application note](https://www.ti.com/lit/an/snla395/snla395.pdf?ts=1663414269224) from TI on how to implement it

gkasprow, 2022-09-18:
I don't think we need to implement entire PD classification and detection because that may cause issues with multi-drop network.
I'd use simple 5V supply with short-circuit detector or even thermal fuse. Did you find PoDL example for 10BASE-T1S ? It's different standard than 10BASE-T1L. Most implementations provide a pair of cables for power delivery. So if we use fixed 5V PoDL we won't violate the 10BASE-T1S standard since the PHY outputs are AC coupled anyway.

gkasprow, 2022-09-18:
I purchased three devkits so we will test various options:
EVB-LAN8670-USB (10BASE-T1S)
LAN+PoE ETH10-2wire-SET ATTE Power (probably 10BASE-T1L)
DP83TD510E-EVM (10BASE-T1L)

gkasprow, 2022-09-18:
I added option 7 to the list

pm-daniel, 2022-09-18:
Good point - the mentioned PoDL implementation is not suitable for multidrop topology. I've looked for some reference implementation of PoDL for 10BASE-T1S but I only found such for point-to-point topology. This [keynote](https://www.ieee802.org/3/cg/email/pdfj_bidpyxzm.pdf) digs into the topic and provides some nice calculations but mentions that PoDL for multidrop is not standardized yet.

Albeit the 7. option looks nice as hardware redesign would be fairly simple I'm a bit worried about the IC availability - it looks to be far worse compared to those from Microchip. Analog Devices also has such a chip in its portfolio - [ADIN1110](https://www.analog.com/en/products/ADIN1110.html) and it looks to be priced slightly higher than NCN26010 but with better availability and shorter lead times.

jordens, 2022-09-19:
* Take a chip from the stm32h7 line. There are a bunch of small packages, have a MAC, are energy efficient and we like them in Stabilizer/Thermostat-EEM.
* If you are interested I could talk to the folks at a neighbor company here about PHY/MAC T1S/T1L solutions. They do a lot of SPE for automotive and industrial systems and have wired up the entire kitchen with it.

gkasprow, 2022-09-19:
Sure, I'd love to have choice, but it's hard to buy any STM32 these days.
@jordens can you show them this issue? Maybe they will have some thoughts.

airwoodix, 2022-09-19:
Given that multidrop SPE has no PoDL, I'm not sure it's very relevant. At least, we'd be happier with a star topology and a single cable per sensor module with limited stress-relief requirements. In particular, sensor modules are likelier to be far apart and inserted/removed dynamically, which makes chains annoying.

I would expect a significant number of free ports on PoE-compatible switchs in typical labs. At this stage, it therefore seems reasonable to me to use one such port per sensor head. If the RJ45/USB-C PoE adapters are quite small, they could either be bunched into a custom switch (would probably fit into a 1U unit) or distributed where there's space. This is surely not very scalable, but feels manageable for few tens of sensors and is practical, since it uses technology already deployed in physics labs.

Or did I miss some motivation for SPE?

gkasprow, 2022-09-19:
The multidrop SPE does not define the way PoDL is implemented.
Since we already use Ethernet in non-standard way (USB-C), I don't see a reason why we can't implement PoDL in simplest possible way.
In order to discuss further we will verify if such PoDL and multidrop will work at all in dynamic conditions.
I've purchased several devkits so first, we will give it a try.
Another way is to implement PoE already in the sensor by adding a third PCB.

pm-daniel, 2022-09-20:
What looks most appealing to me, in regards to multidrop SPE is the flexibility. If the multidrop SPE "switch" would be designed (ex. 4 or 8 SPE ports, using the standard ethernet switch as a base to build on) one can combine both star and bus topologies in one system - so we kinda get 2in1.

gkasprow, 2022-09-20:
The SPI MAC+PHY from Onsemi supports up to 25 devices in one segment. Microchip ones supports up 8devices  in network segment. Let's check interoperability and hot-plug performance od the network.

gkasprow, 2022-09-27:
We can also go for STM32F777VIH6 in TFBGA100 which is somehow available and offers high performance.
It has 0.8mm pitch so could fit on 4layer PCB

gkasprow, 2022-09-28:
the NCN26010 chips are now available in[ Arrow](https://www.arrow.com/en/products/ncn26010xmntxg/on-semiconductor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)
So we can use them in the design simply replacing existing MAC+PHY with this one.

pm-daniel, 2022-10-24:
Okay, so yesterday I tested 10BASE-T1S in a simple peer-to-peer configuration using NCN26010XMNEVK and EVB-LAN8670-USB and I can confirm that it works as expected
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

gkasprow, 2022-10-24:
so, the interoperability between Microchip and Onsemi chipsets exists :)

gkasprow, 2022-10-24:
I ordered both STM32 and NCN chips without problems.

pm-daniel, 2022-10-25:
Which STM32 have you ordered finally?

gkasprow, 2022-10-25:
STM32F103T8U6TR

jordens, 2023-02-08:
The folks down the corridor pointed to [their](https://gitlab.com/perinet/product-documentation-artifacts/-/raw/main/PRN100301%20-%20periCORE%20Product%20Summary.pdf) [products](https://www.perinet.io/files/custom-theme/docs/product-summary/PRN100546%20-%20periCORE%20Development%20Kit%20Product%20Summary-1.pdf) and mentioned they would always prefer separate power (as there is little cabling/connector advantage with PoDL in practice but big price for the trafo/decoupling/SI management/consumption/robustness to be paid for PoDL). They just run two pairs. And multidrop appears to be problematic in practice for reasons of stub length, robustness and flexibility. They would also recommend 100BASE-T over 10BASE-T for SI and future proofing reasons.
Maybe trying their modules wouldn't be all that stupid. Then one could focus on the frontend development. It would need to be a separate small stm32f1 or similar for adc/dac handling and signal processing hooked up via uart and gpio to the network module.
Obviously there's a lock-in into their development environment and onto their code but to get started in some thesis project it would be fine as a first shot.

gkasprow, 2023-02-11:
The version with Onsemi MAC+PHY and low-cost STM was already prototyped. We checked interoperability with Microchip chipset. The modules are nice but won't fit into the enclosure and would significantly increase the cost. We are currently producing a series of 5 devices to see how they work together.
We can always supply our devices via USB.

Thread 19 (2022-12-01):

DiPho v2 ready for review

pm-daniel, 2022-12-01:
@gkasprow I've just pushed the final changes to second revision of the project. It's ready for review and hopefully prototype manufacturing.
Additionally I designed a breakout board which would be helpful during potential hardware debugging and firmware development phases. Picture below.
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

gkasprow, 2022-12-20:
- [ ] use holes in the debug board - it's easier to attach probes without damaging SMT pads
- [ ] what's the point of using IC2B?
- [ ] was the analogue switch leakage current issue resolved?
- [ ] use naming convention as in other SInara projects: PA4V5 -> P4V5A;
- [ ] there is LOG assembly variant, but the log amplifier is not present on schematics
- [ ] there was a shield used (4 clips). Does the shield exist as a part number, or it's custom-made?

gkasprow, 2022-12-20:
digital board
- [ ] why was OSC1 used instead of crystal? Oscillators are usually more power-hungry and more expensive. can we use CLKO of IC5 to drive the MCU?
- [ ] such configuration causes ERC error. Use ports only to connect sheet hierarchy.
- [ ] why was OSC2 used instead of crystal? Oscillators are usually more power-hungry and more expensive.
- [ ] I'd pull RSTn low to keep IC5 in reset by default. What's the point of R9?
- [ ] keep power rail naming convention (PFILT3V3)
- [ ] does R10/R11 need to be 0805?
- [ ] I wouldn't say I like how L4 is connected. Are you sure the windings are connected correctly? IMHO there should be 2 individual coils; otherwise, the Ethernet signal will be shorted.

gkasprow, 2022-12-20:
- [ ] remove the PoE adapter project
- [ ] Instead of a PoE adapter I'd make a simple router based on RPI nano, the same NCN chip and Ethernet to USB converter and place it into the same case as before. This adapter would provide power to all devices as well as SPE Ethernet connectivity.

pm-daniel, 2022-12-23:
I used oscillators instead of crystals because constrained space and routing possibilities. In case of oscillators I don't have to route two tracks with caution but only single one (additionally without having to worry so much about track lengths and so on), I chose oscs that are fairly inexpensive.  We cannot use CLKO as it provides fixed 25MHz output and with PLL embedded in STM32 one can not obtain 48MHz clock needed for USB.

RSTn pin of IC5 - external pull-up resistor was used in accordance to IC data sheet, internal pull-up is fairly weak so manufacturer recommends using an external in "noise sensitive applications" (whatever that means in that case). Additionally such a resistor is also used in development board.

L4 is connected as a differential-mode choke, I've seen such a connection in many papers discussing PoDL in SPE. ex.
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
page 8 in [this keynote](https://www.ieee802.org/802_tutorials/2015-11/PoDL_tutorial_1115.pdf)
or in this diagram from HARTING
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
Albeit I'm not entirely sure whether such a connection is correct.

pm-daniel, 2022-12-23:
Regarding AFE board - MAX4639 has extremely small leakage current and package that is easy to route while being available quite fairly.

IC2B was used to "isolate" (not the best wording probably ;) )sensitive offset voltage coming into TIA from ADC an digital stuff (whole TIA offset net is routed inside of shield thanks to that). Also that part was already available so...

those pads on debug board are meant for keystone 5015 SMD test points but I will change them to THT version

gkasprow, 2022-12-30:
ACK with transformer

gkasprow, 2022-12-30:
go on with routing

pm-daniel, 2022-12-30:
@gkasprow Both boards are routed already ;)

regarding "router" - did you mean raspberry pi compute module? Because I haven't found any info on "RPI nano".
do we want only single SPE port? or ex. two of them (thus single NCN chip or more?)
do we want PoE power or external via barrel jack or usb-c or any other connector? maybe both?
do we want any other connections? ex. shell via uart or sth like that?

gkasprow, 2022-12-30:
I meant "Raspberry Pi Pico W". But there is an issue with USB connectivity.
Essentially you would have to use right angled PCB mounted USB plug to get USB connectivity needed for network adapter. Sth like [here](https://botland.com.pl/rozszerzenia-gpio-i-nakladki-hat-do-raspberry-pi-zero/21702-adapter-raspberry-pi-zero-do-3b-waveshare-22382.html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)
Let's add two SPE ports
USB-C is good enough; when necessary one can use Ethernet to USB-C PoE injector
You can use [this project](https://github.com/michalgaska/home-assistant-controller) as a template

gkasprow, 2022-12-30:
This template project uses PoE so we can copy it.

gkasprow, 2022-12-30:
one can use such connector as well https://thepihut.com/products/solderless-zero-dongle-for-raspberry-pi-zero

Thread 21 (2023-05-07):

DiPho casing

szymons90, 2023-05-07:
[DiPho_20230507.zip](https://github.com/sinara-hw/DiPho/files/11413999/DiPho_20230507.zip)

Hi,
I prepared two versions of DiPho casing, both consist of two parts - the base and the main housing. There is a sligth difference in an approach to manufacturing.
In V1, the base can be made only by milling from one surface, while the housing by turning and milling. Both parts are screwed together with 3 x M3 screws. This is a slightly more expensive solution, but lighter - the mechanics weighs about 14.5 g
In V2, the base can also be made only by milling, but the casing only by turning (except for the holes fixing the whole thing, but you don't need a special machine for that, you can do it by hand). In this version I used 4 x M2 screws to connect the whole thing. This solution should be a bit cheaper, but it's also a little bit heavier (18.7 g).
In both versions, the SM1 thread for the Thorlabs tube must be made by a die - you can buy one on aliexpress or ebay. On the other hand, if we had a skilled technologist, maybe after a few tries we could make such a thread on a lathe.
PCBs are attached directly to the base. The problem is that due to the small mounting screws - M1.4 - there are no such standard spacer. I suggest to buy some brass tube fi 2 x 1.6 and cut them into pieces. It will be a bit more annoying to mount, but right now, I don't see any cheap and easy solution here.
@gkasprow , @pm-daniel  I am waiting for your comments. Let me know if you prefer one of these versions or if you want a different approach. Step files are in attachment,

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

gkasprow, 2023-05-07:
I like the second idea.
What if we 3D print the base and attach only the threaded tube?

gkasprow, 2023-05-07:
I think we need the photodiode surface much closer to the edge, as in the original Thorlabs module.

gkasprow, 2023-05-07:
For mounting hole we could use threaded insert

szymons90, 2023-05-07:
1. Sure, if there are not any special environmental requirements, I don't see any problems.
2. Ok, I'll fix it in next revision
3. Ok, I'll modify the design, in which mounting threaded holes will be in the 3D printed base. The housing will have just an SM1 thread to the tube.

gkasprow, 2023-05-07:
are you sure 3D print technique can print such thread? Would it be durable? I'd opt for metal thread insert for both SM1 and side fixing hole

szymons90, 2023-05-07:
No, I was thinking about leaving the SM1 thread in the metal element (2). This base (1) could be printed with a standard M4 threaded insert installed.
Sorry, the M4 thread was missing from the project, in the second screen it should be visible. Of course, thickness in this region shall be slightly enlarged

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

gkasprow, 2023-05-07:
are you sure Thorlabs is using M4 thread? I thought it was some imperial standard

szymons90, 2023-05-07:
From what I see for mounting fixtures they use either M4 or 8-32 - below I send an example link:

https://www.thorlabs.com/drawings/6c7f99117867bfa3-AA0B5334-E89D-E8F4-0EC272DA9CFEEE88/LMR1_M-AutoCADPDF.pdf

gkasprow, 2023-05-07:
Ok, makes sense, I have US version :)

szymons90, 2023-05-08:
Ok, take a look at the V3. Nylon-printed Base (I had to thicken it to add the necessary material for threaded inserts) and aluminum Housing, made just by turning. As the thickness of the base increased, the height of the housing decreased, thus the entire thing should be a little bit cheaper, and lighter than V2. The Base flange is relatively thick, but I don't think that's a problem, as the nylon has less density than aluminum. But we have to pay attention to the M1,6 mounting screws for PCB - there are not such small inserts on the market, thus we will have to use self-tapping screws - but to be honest I don't think that it will be a problem. We can also check taps for plastics - as far as I know, there are such things on the market.

[DiPho_V3_20230508.zip](https://github.com/sinara-hw/DiPho/files/11424579/DiPho_V3_20230508.zip)
![DiPho_V3 1](https://user-images.githubusercontent.com/132475730/236917610-31f15f1a-dcbd-4805
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
-ba5e-22
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
88f4cf20d2.PNG)

szymons90, 2023-05-08:
Section view didn't load correctly, here it is:

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

szymons90, 2023-05-08:
Hmmm, I've got two ideas at the moment:
1. To use the side surface of the PCB - but I don't think that would work.
2. To replace two bushings with a single 3D printed ring with holes, which will be located between two PCBs and supported on a larger surface. Such solution will make these PCB as some kind of sandwich structure

szymons90, 2023-05-10:
Ok, take a look at the V4 version. It's all 3D printed. As we talked yesterday, we can glue the retaining ring for 1 inch tube to the housing. This would allow to attachment of a standrad 1 inch tube. The only thing that worries me relates to the length of such a ring - it's just 2 mm. If needed, we can use standard plastic rings, which have 2,8 mm in length.

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

[DiPho_V4_20230510.zip](https://github.com/sinara-hw/DiPho/files/11438531/DiPho_V4_20230510.zip)

szymons90, 2023-05-10:
Also, as I mentioned before, I replaced two brass spacers, by a single one ring, which allow to keep perpendicularity of the PCB surface. In this version, there is no custom metal parts.

gkasprow, 2023-05-10:
LGTM. I'd move the threaded ring by 0.5mm from the edge

szymons90, 2023-05-29:
Hi,

Just finished an integration of the first prototype. IMHO it looks OK, but there are still a few things I'd like to improve in the next versions:
1. In my opinion, the mounting holes of the M1.6 in PCBs are unnecessary. Both PCBs are well positioned on the cutouts on the connectors, and since there is a ring between the plates, they also hold reliably. There are no such small inserts, so to use these holes, we would have to either thread them or use some self-tapping screws. Additionally, there will be a little more space for components.
2. I have to increase the cut-outs in which boards are placed because I did not take into account that after cutting the PCB, small teeth remain on the edges. There is no point in grinding them, increasing the diameter by 1.5 / 2 mm should do the trick.
3. I also need to increase the clearance between the ring and the housing a bit, after printing it is quite tight.
4. The patent with the snap ring to the lid works well. We didn't even buy UV glue, we used plain cyanoacrylate for now.
5. I used an additional o-ring between the PCB with the diode and the cover - so that, in case of emergency, no light gets in from the side of the slots with connectors. We can get rid of it if necessary, but it costs 50 gr each. This also makes it a bit more secure. They are presented in the section view below.

Here are some photos. In my opinion, if it was painted black and the screws were blackened, it would look very nice. Let me know what do you think.
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

gkasprow, 2023-05-29:
yes, painting is a must.
Can we place text on the back side?
otherwise we would have to print and stick a label...

gkasprow, 2023-05-29:
otherwise it looks great

szymons90, 2023-05-30:
There should be no problem with a text - let me know what it should be and if there is any font or logo.

There is also an issue of LED pipes - we are thinking about getting rid of them. They are relatively expensive (PLN 5 / piece), which is an unnecessary cost regarding this size of casing. Besides, since it will be used indoors, it doesn't have to be 100% sealed from the connector side. And they are still problematic to assemble... We would just prefer to slightly modify the housing in this place, to make some kind of lip, so that it would almost stick to the diodes. What do You think?

gkasprow, 2023-05-30:
Text:
SPE close to a 2-pin connector
TERM near to the switch
OUT close to the coax connector
and USB

and, of course, DiPho v1.1

I would also add some plastic around USB and SPE connectors so they are more visually part of the enclosure
about LEDs - the hole would be fine, just add some lips or tubes around so the light is not scattered inside the enclosure.

szymons90, 2023-05-31:
Sth like that? Maybe I'll try to make the font sligthly bolder, to increase the text quality after printing.
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

szymons90, 2023-05-31:
Ok. What about the font and its size? Is it OK?

gkasprow, 2023-05-31:
yes

szymons90, 2023-05-31:
Better? The problem with the coax connector is that it is lower than the SPE and USB, so i made a groove around it.
Are the subtitles ok or would you like all of them horizontal?

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

gkasprow, 2023-05-31:
Do we need this groove around coax comnectot?

szymons90, 2023-05-31:
From my opinion, it would be the best to leave the space around this connector free. It barely sticks out of the casing.
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

szymons90, 2023-09-04:
Finally, the painter finished these housings (2 months... - no comments). IMHO it looks pretty good, although the color was supposed to be matte black, and it is slightly glossy.

Overall:
- IMHO there is no point in playing with convex letters, the prints look cool.
-  I would also get rid of flanges protecting the connectors, I would make the whole bottom flat, so that it would print comfortably.
- there's also nothing to play with LED pipes, but we've established that before.

Let me know what do You think.

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

gkasprow, 2023-09-04:
looks good to me

pm-daniel, 2023-09-04:
As we discussed - separate LED's should be merged into bicolor one, of bigger size in the next revision. That would simplify that part of the design.

During bring up I found few other electronic design issues, I will describe them soon in separate thread.

szymons90, 2023-09-04:
No problem, the technology is under control, so any changes to a serial product will not be problematic.
As for the LED holes, yes, I do remember, a single one will definitely be better.
Just let me know when you have the stepper ready
