sinara-hw/DiPho/DiPho_devboard/Project Outputs for DiPho_devboard/DiPho_devboard_assembly_drawing.pdf

P1

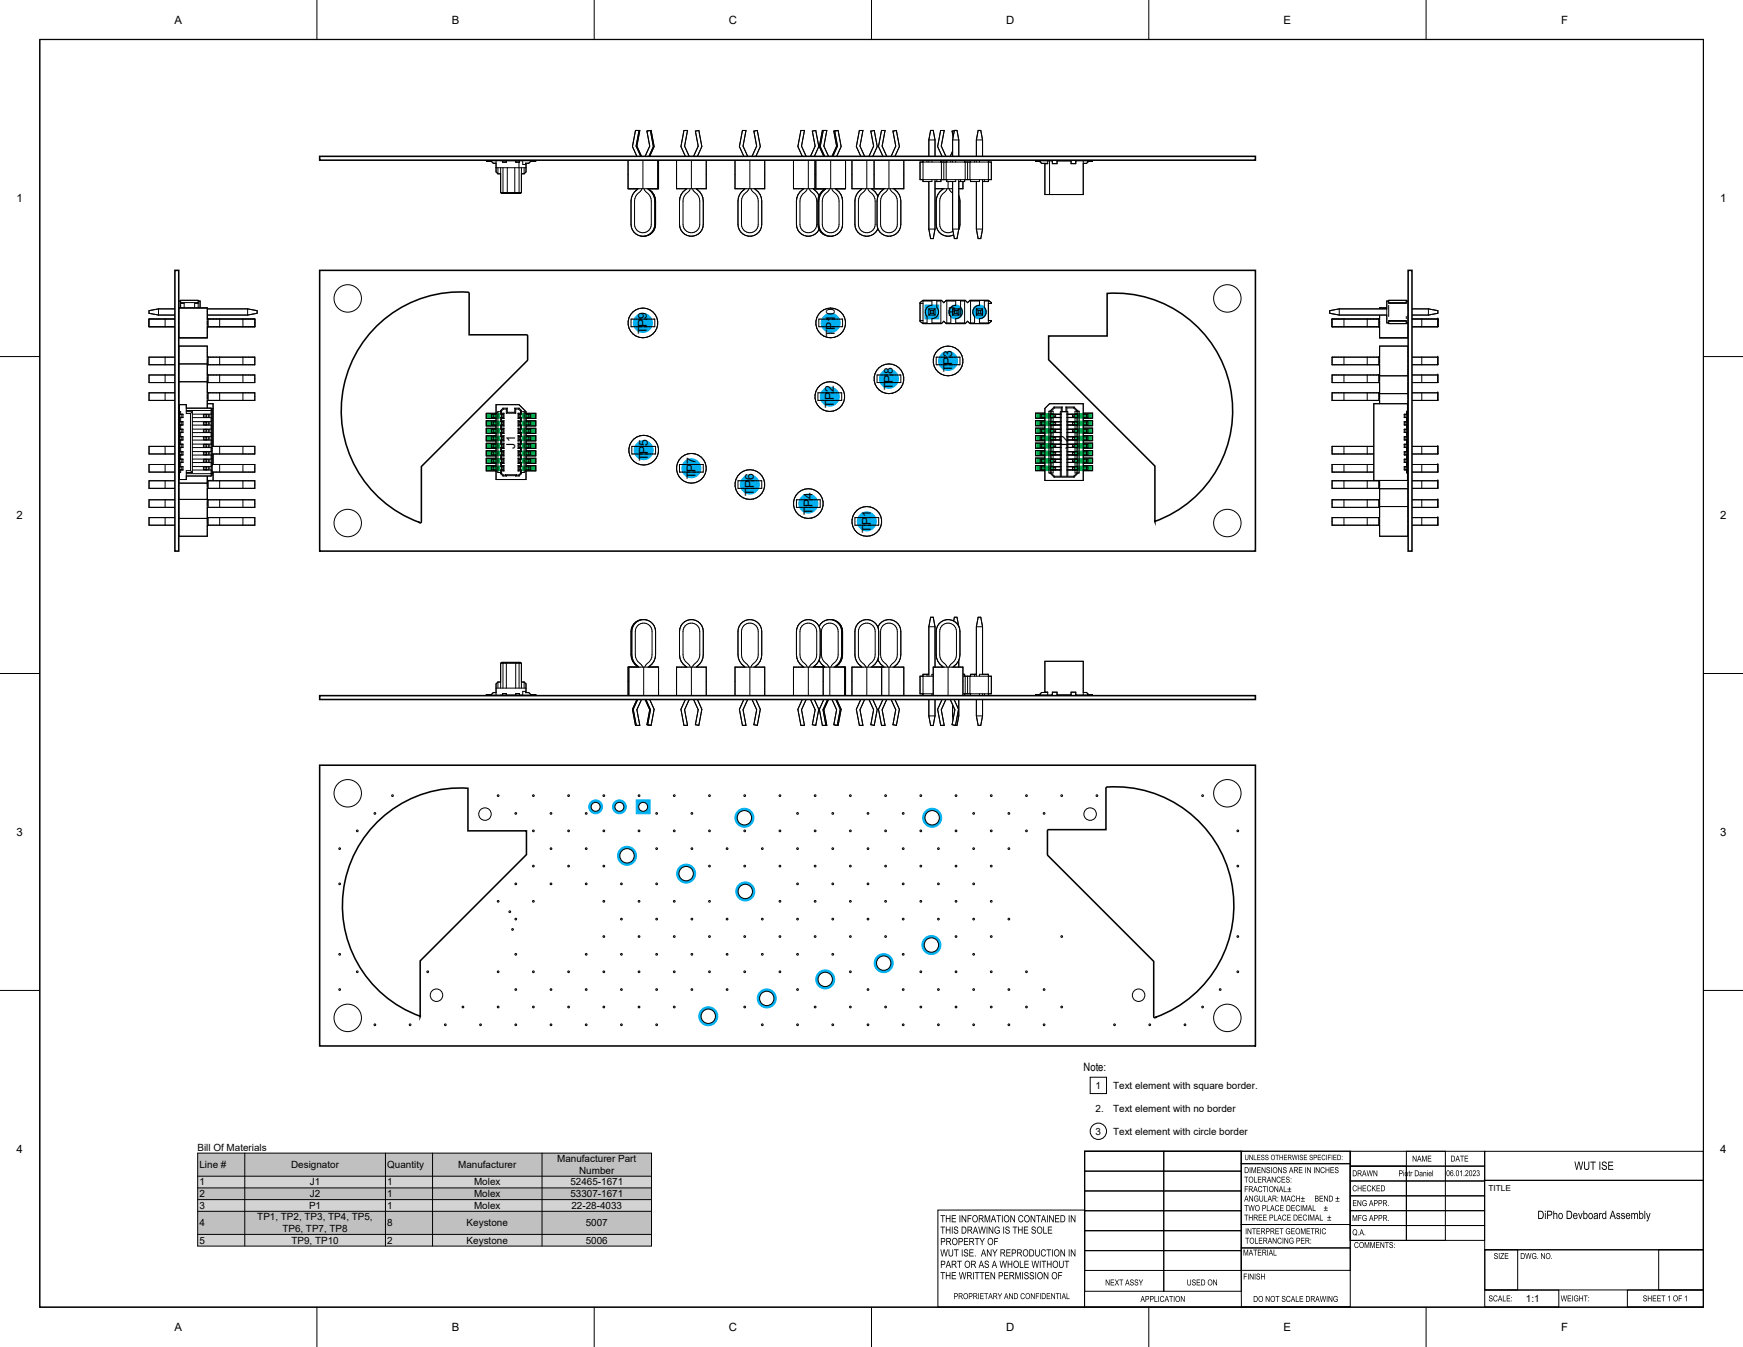
[picture p1: page 1]
J2 TP⁵; TP⁸ TP⁷; TP⁴; TP¹ TP⁶; TP³ TP² TP⁹; TP¹⁰; TITLE; Line #; Designator; Quantity; Manufacturer; Molex Molex Molex; Keystone; Manufacturer Part Number 52465-1671 53307-1671 22-28-4033; Bill Of Materials

Note:
1 Text element with square border.

2. Text element with no border

3 Text element with circle border
