sinara-hw/DiPho/DiPho_digital/Project Outputs for DiPho_digital/DiPho_digital.pdf

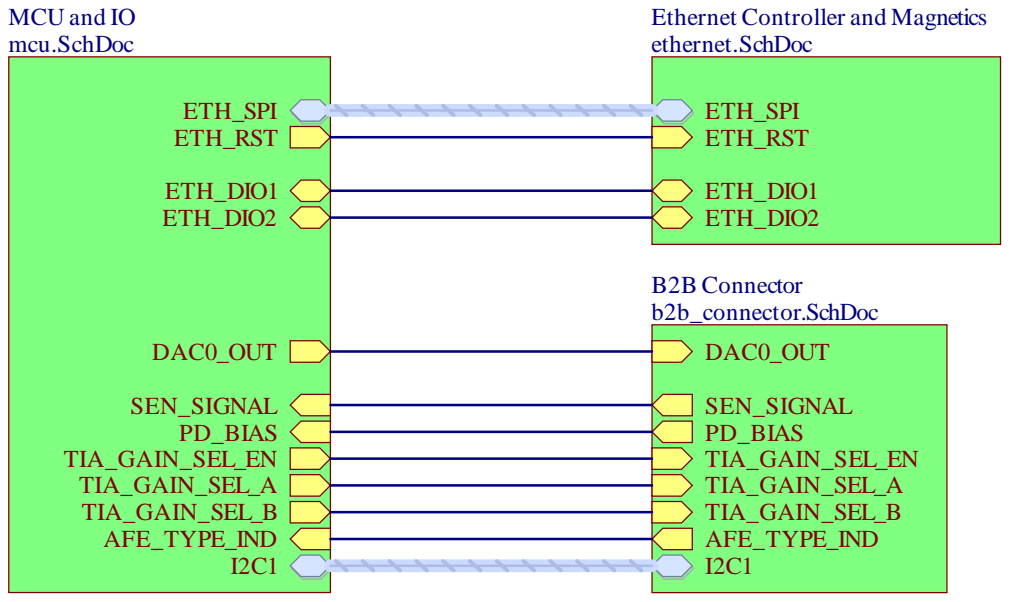
[picture p2: page 1]

Ethernet Controller and Magnetics
ethernet.SchDoc

This documentation describes Open Hardware and is licensed
under the CERN OHLv.1.1. You may redistribute and modify this
documentation under the terms of the CERN OHLv.1.1.
(http://ohwr.org/CERNOHL). This documentation is distributed
WITHOUT ANY EXPRESS OR IMPLIED WARRANTY,
INCLUDING OF MERCHANTABILITY, SATISFACTORY
QUALITY AND FITNESS FOR A PARTICULAR PURPOSE.
Please see the CERN OHLv.1.1 for applicable conditions.

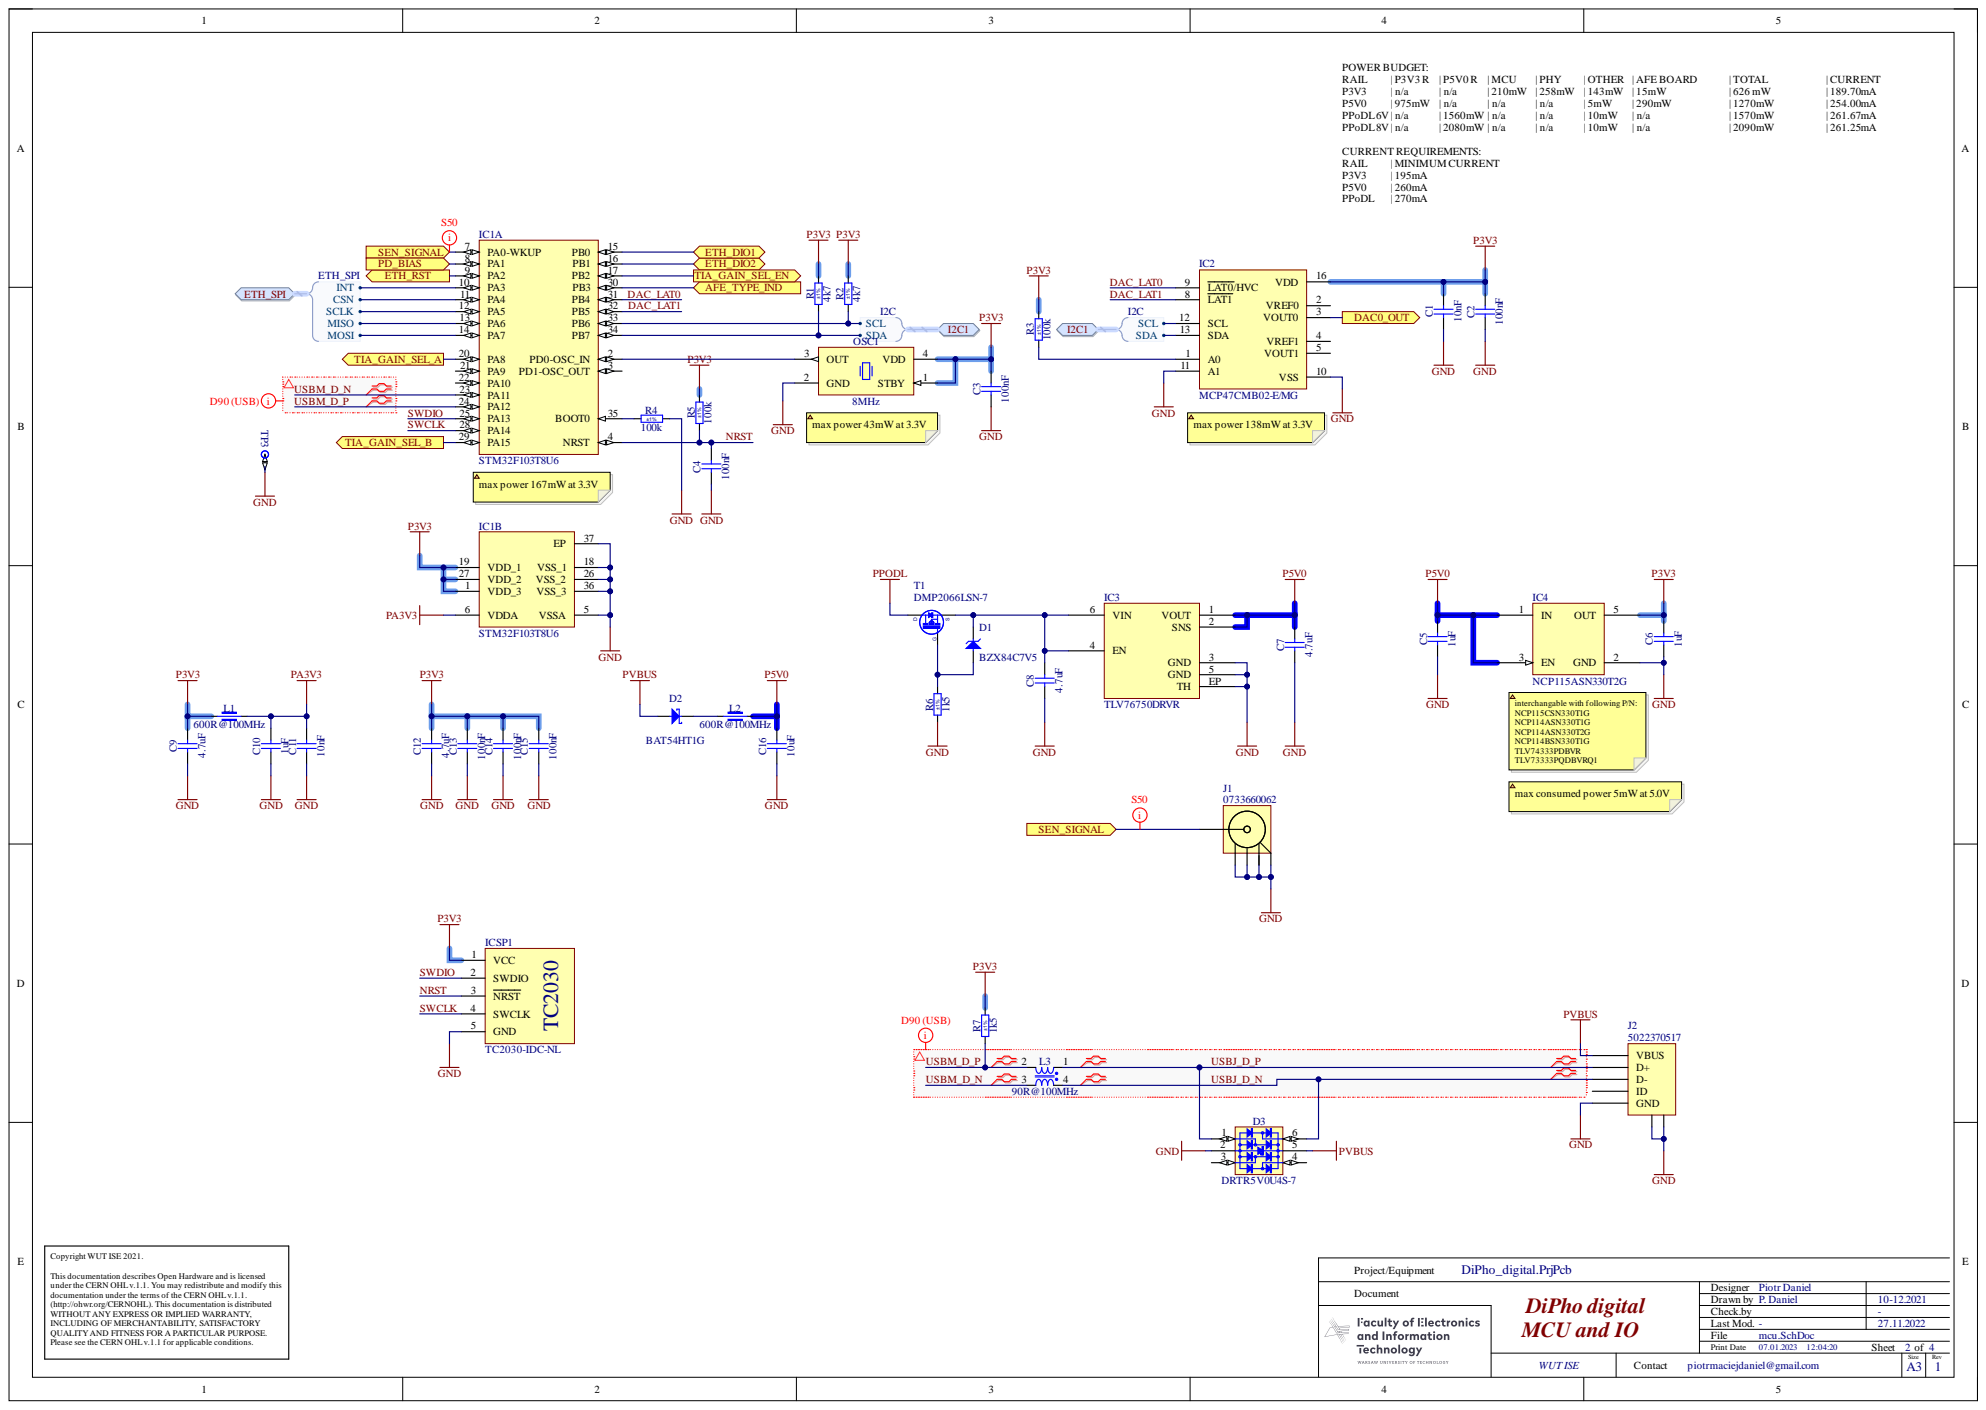
[picture p3: page 2]

OUT 3

PA9 21 | GND 2

max consumed power 5mW at 5.0V

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

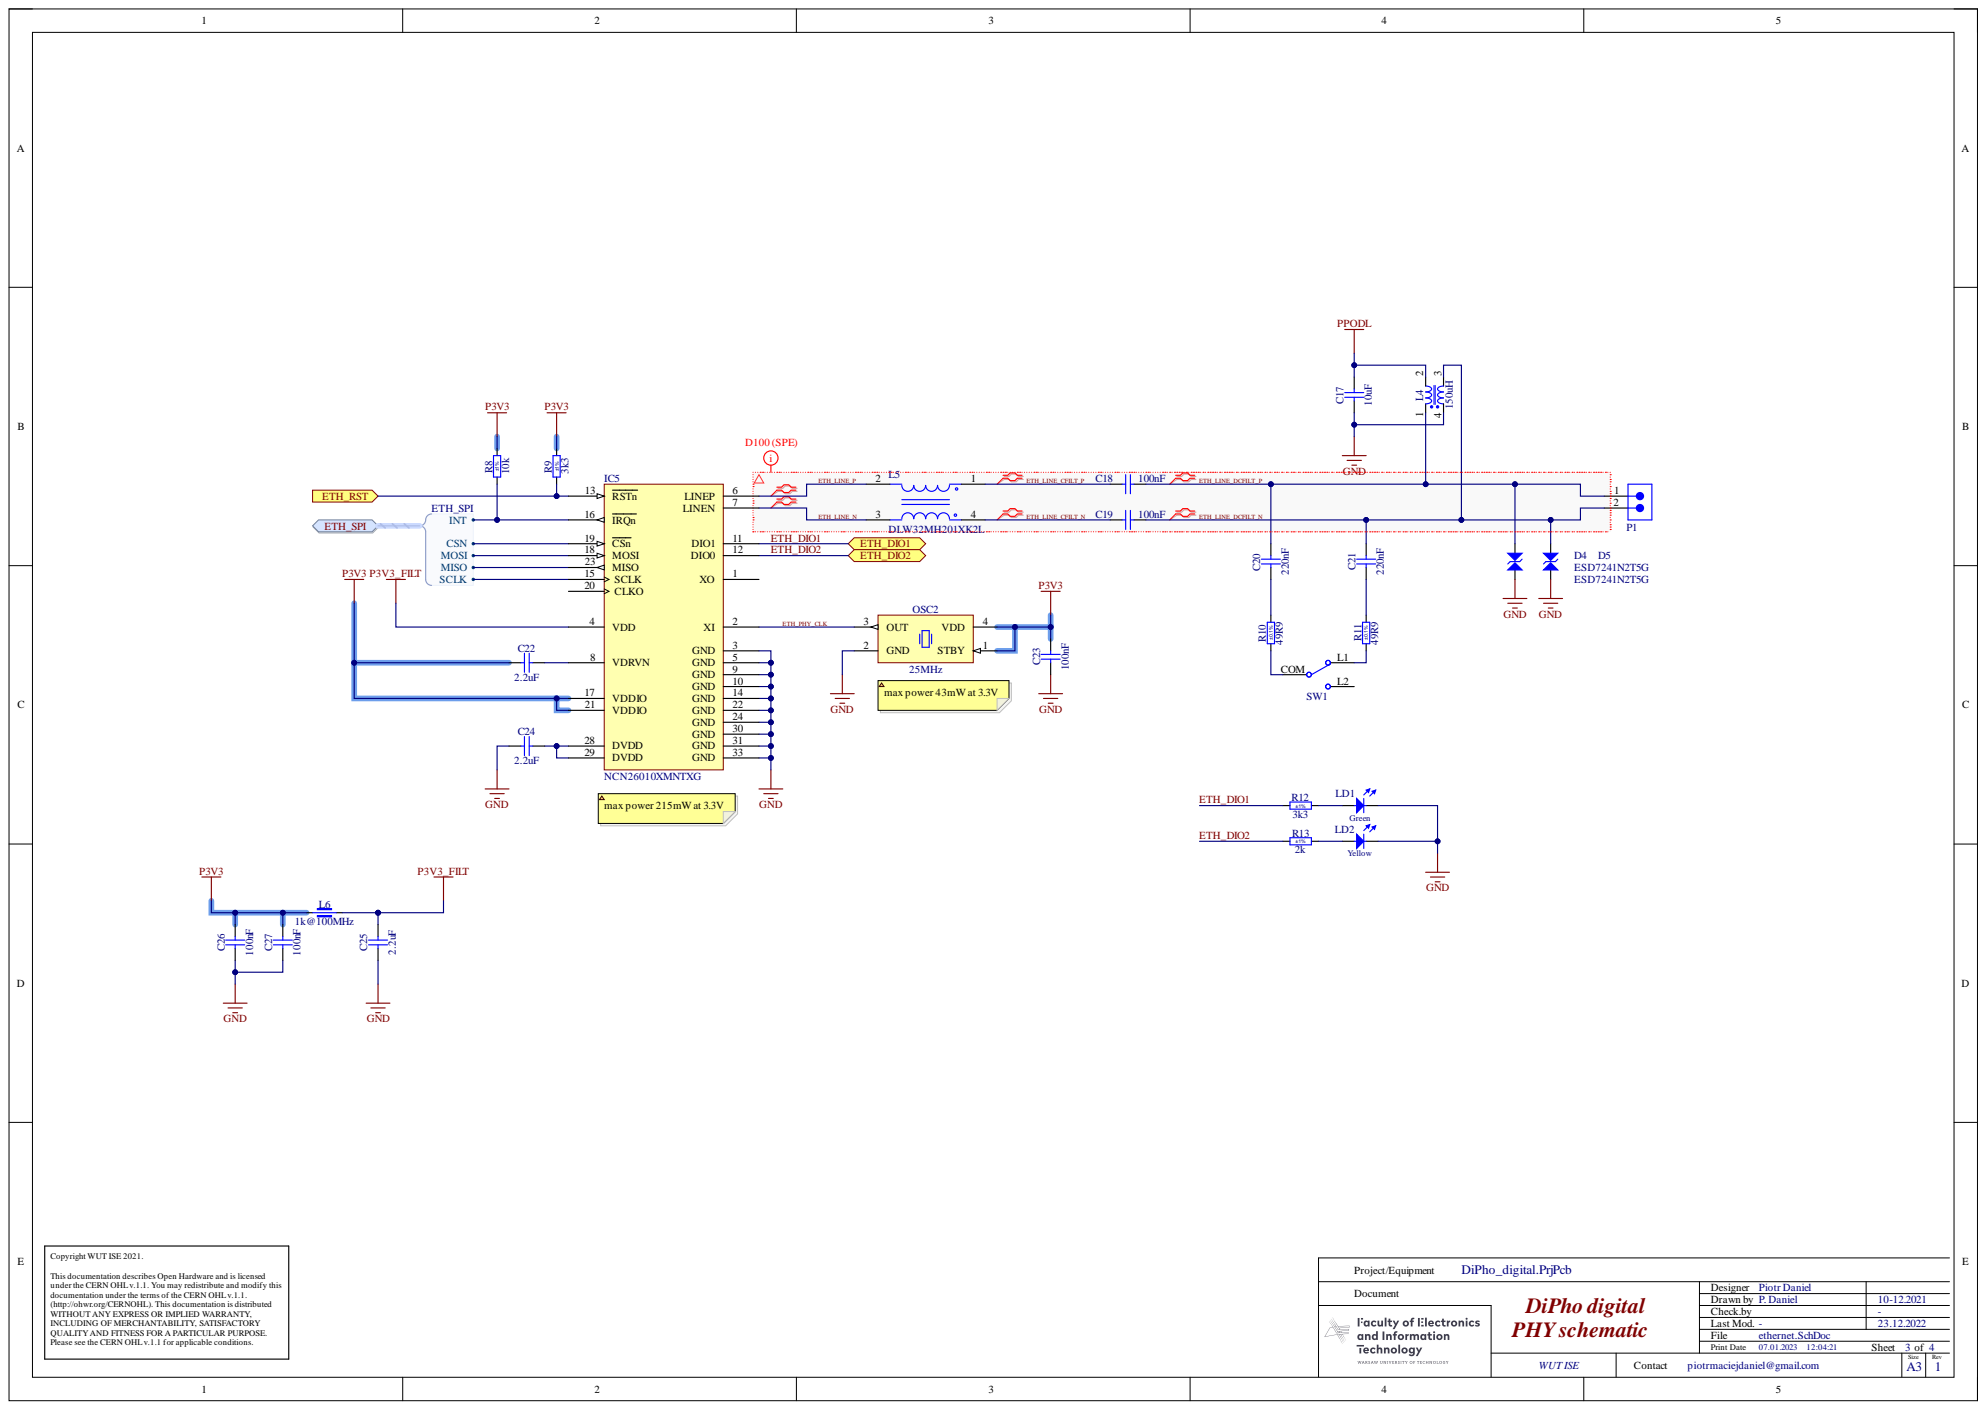
[picture p4: page 3]

OUT 3

C22 | VDRVN 8 | GND 2

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

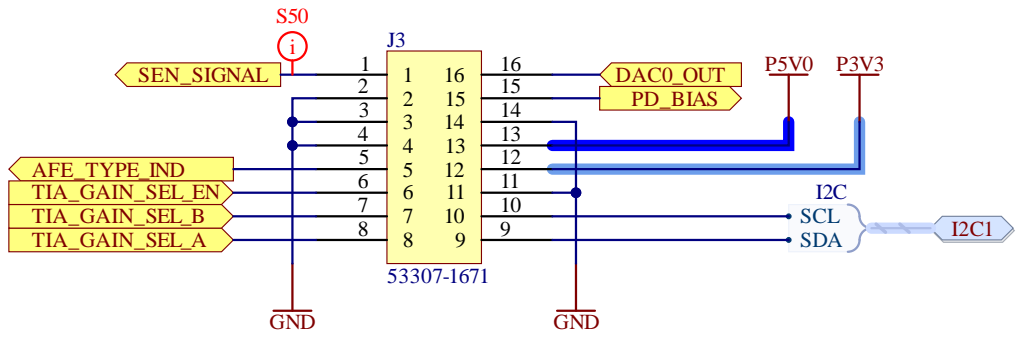
[picture p5: page 4]
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

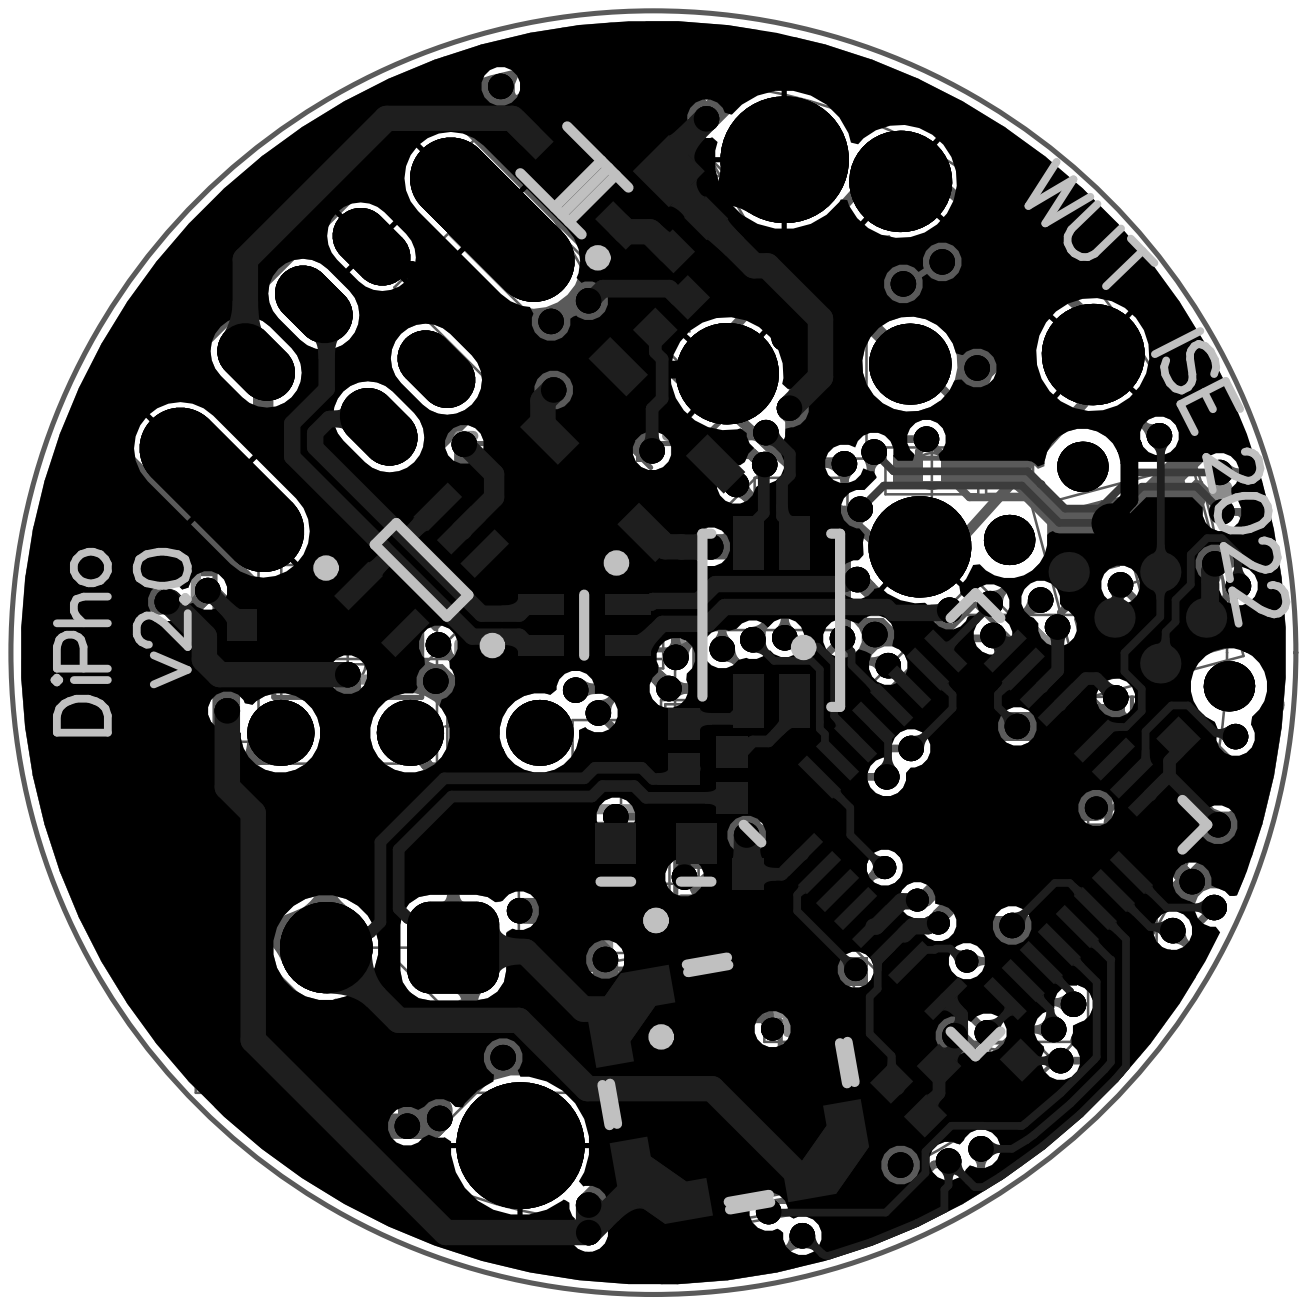
[picture p6: page 5]
