sinara-hw/DiPho/DiPho_AFE/Project Outputs for DiPho_AFE/DiPho_AFE.pdf

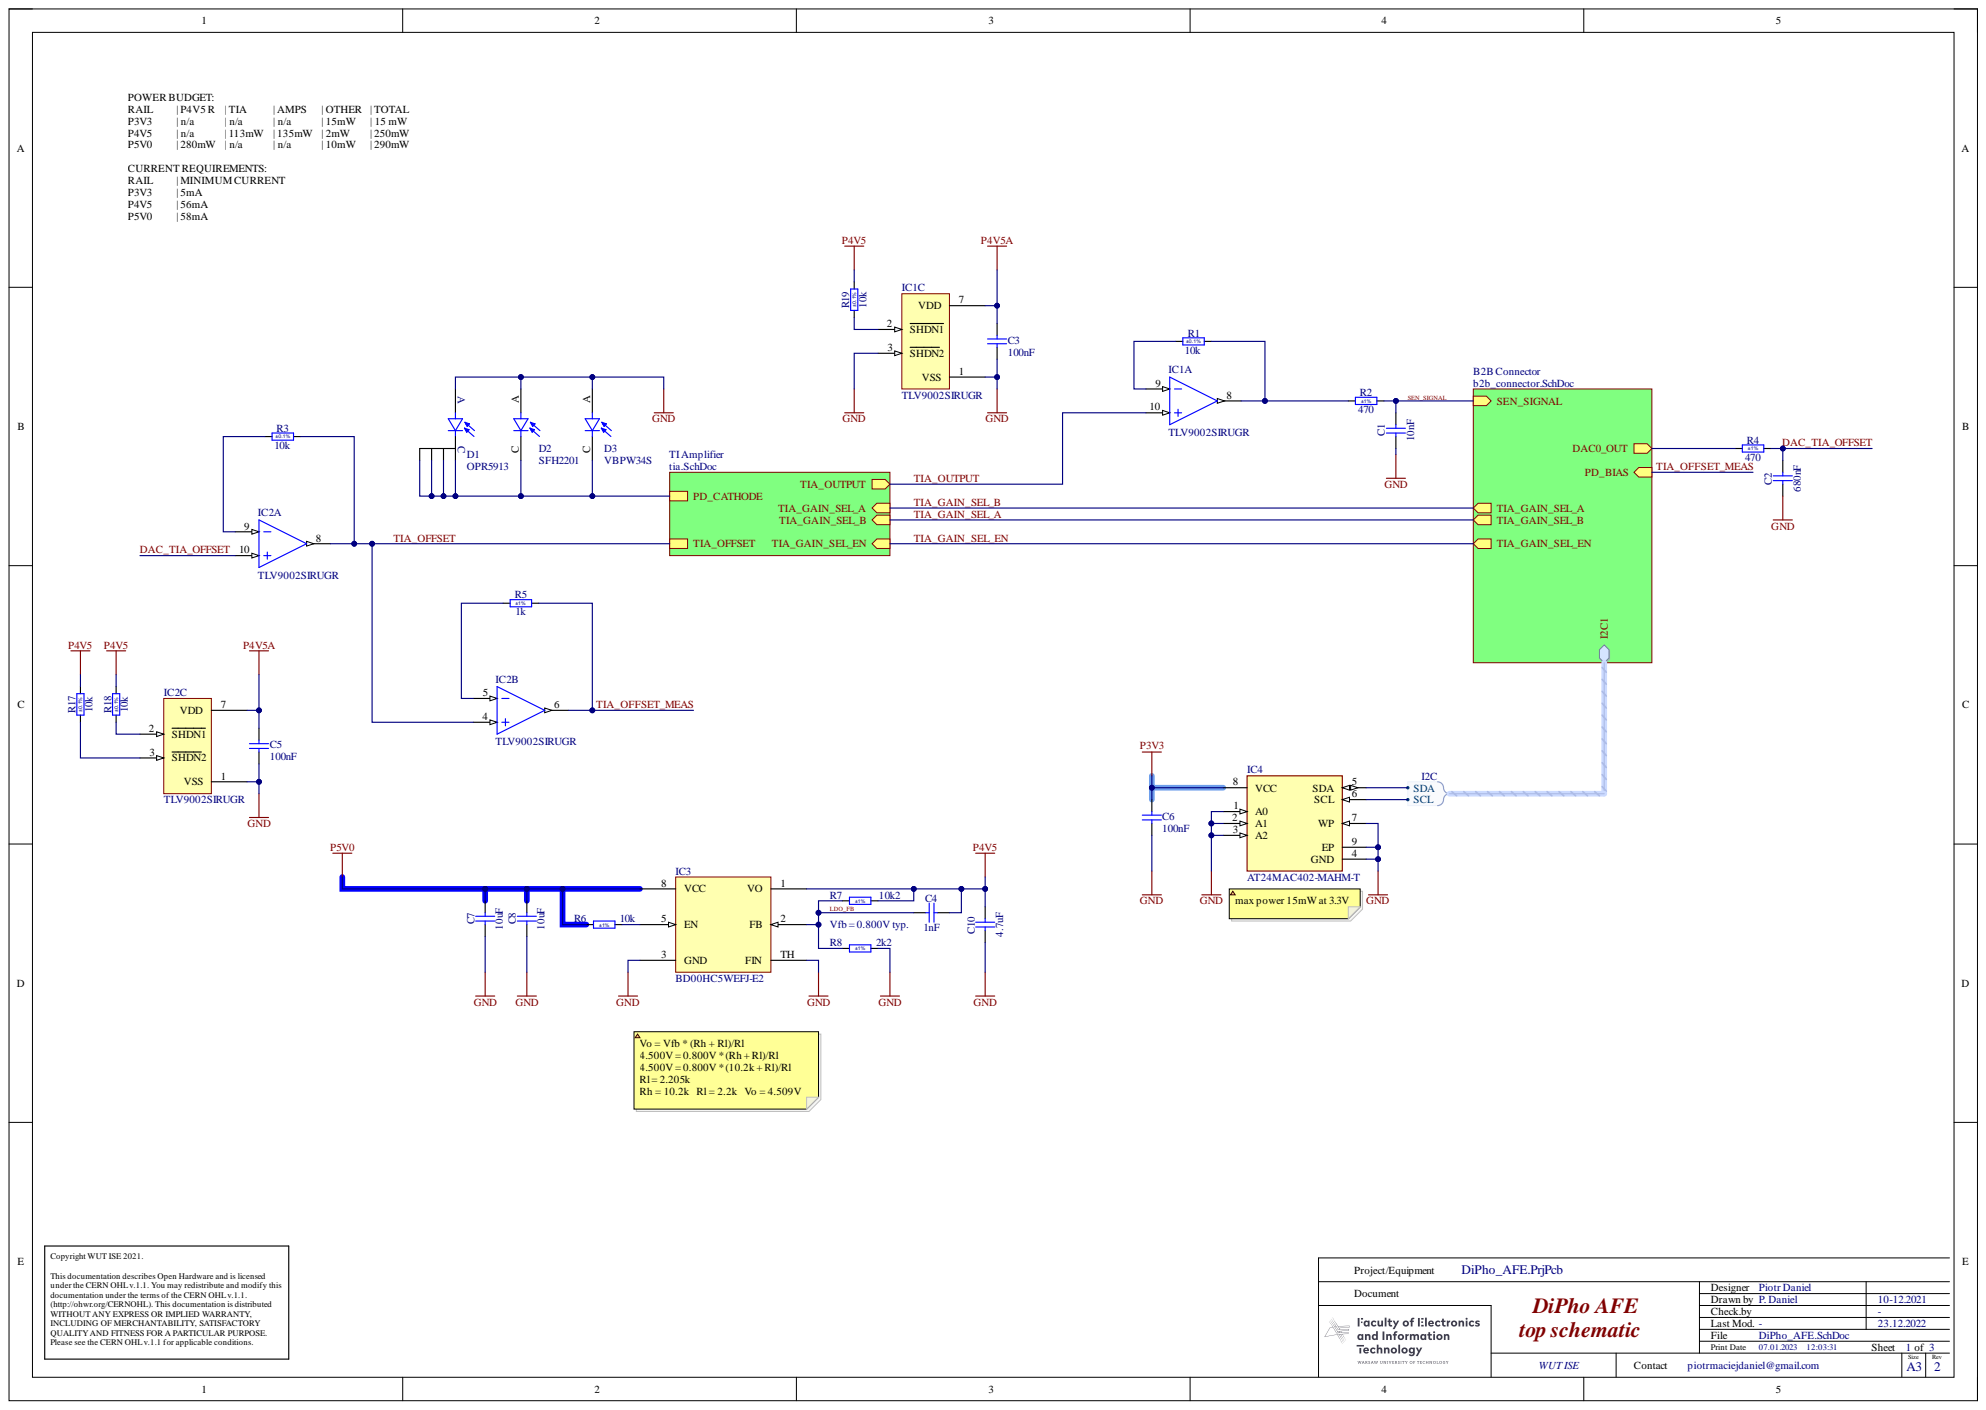
[picture p7: page 1]

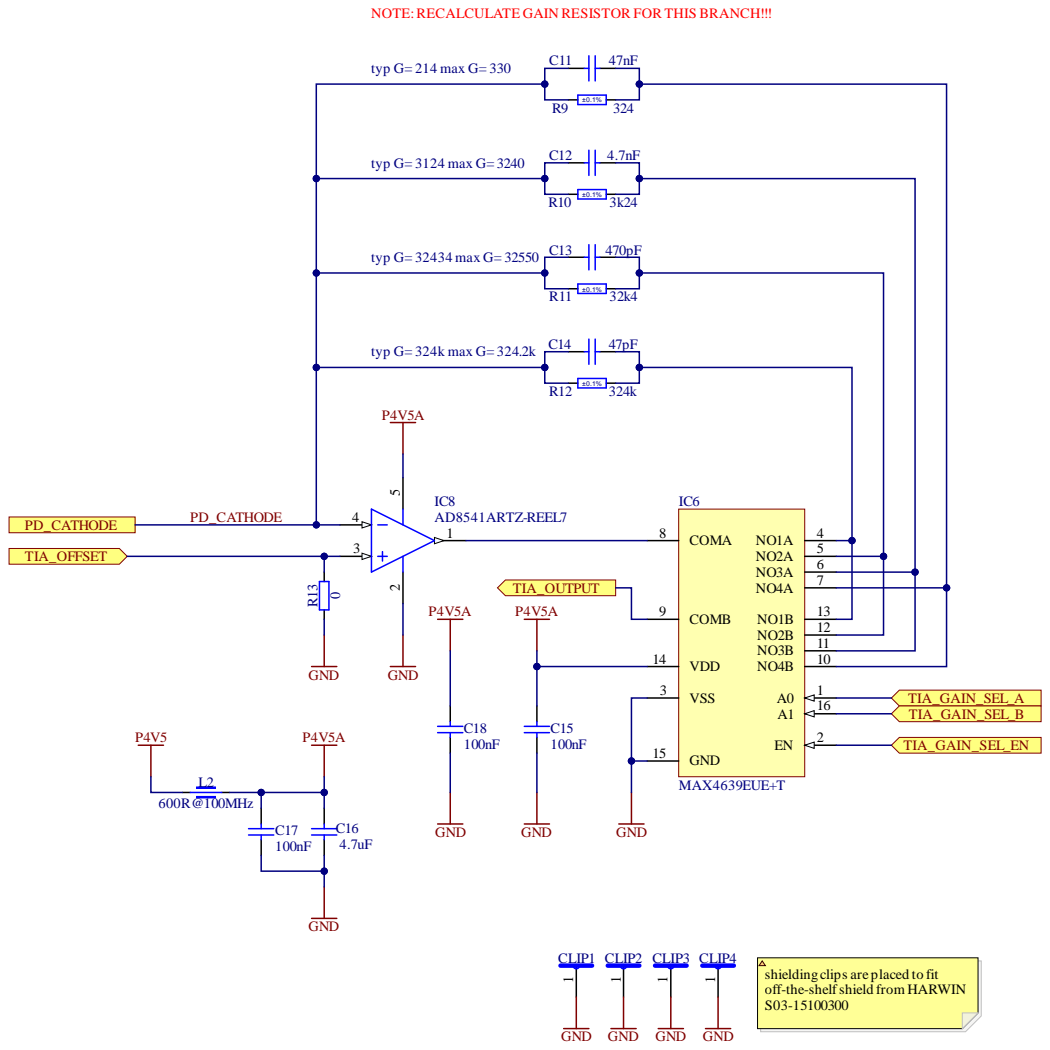
[picture p8: page 2]

NOTE:RECALCULATE GAIN RESISTOR FOR THIS BRANCH!!!

shielding clips are placed to fit
off-the-shelfshield from HARWIN

This documentation describes Open Hardware and is licensed
under the CERN OHLv.1.1. You may redistribute and modify this
documentation under the terms of the CERN OHLv.1.1.
(http://ohwr.org/CERNOHL). This documentation is distributed
WITHOUT ANY EXPRESS OR IMPLIED WARRANTY,
INCLUDING OF MERCHANTABILITY, SATISFACTORY
QUALITY AND FITNESS FOR A PARTICULAR PURPOSE.
Please see the CERN OHLv.1.1 for applicable conditions.

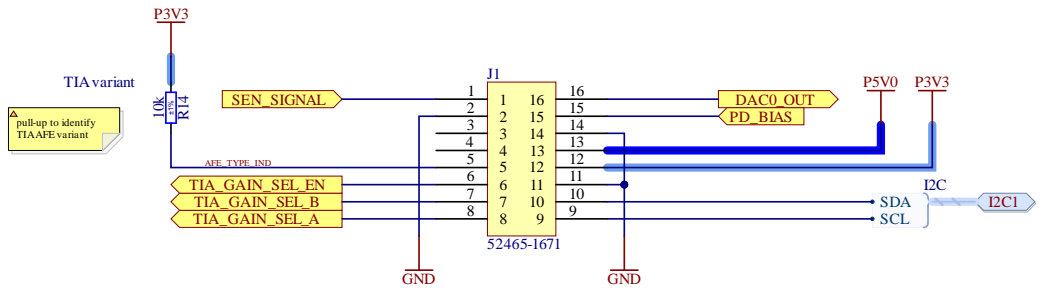
[picture p9: page 3]

AF E _ TYP E _ IND | | 4 | 1 3

1 1
1 0

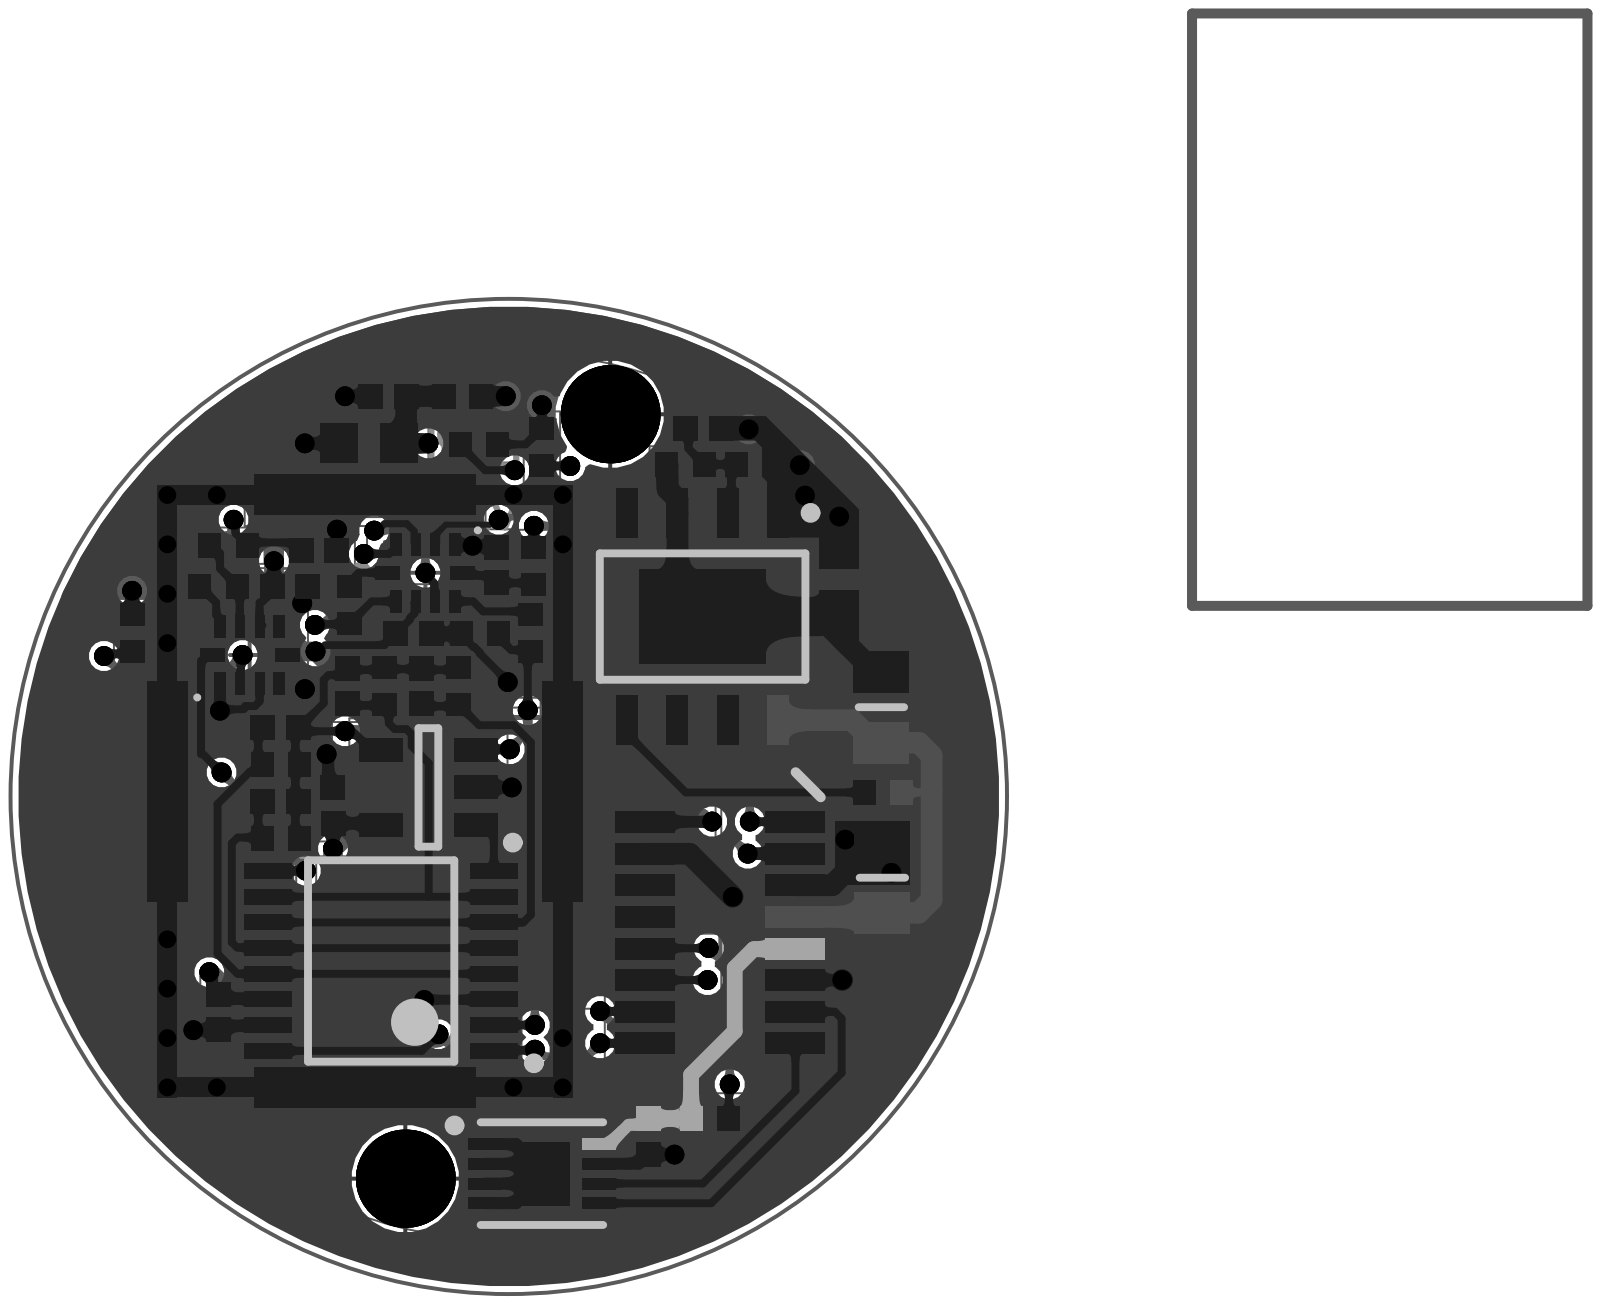
[picture p10: page 4]
