sinara-hw/DiPho/(list of files, drawings)

Other design files:
DiPho_adapter/DiPho_adapter.PrjPcb
DiPho_AFE/b2b_connector.SchDoc
DiPho_AFE/DiPho_AFE.PcbDoc
DiPho_AFE/DiPho_AFE.PrjPcb
DiPho_AFE/DiPho_AFE.SchDoc
DiPho_AFE/log.SchDoc
DiPho_AFE/tia.SchDoc
DiPho_analog/DiPho_analog.PrjPcb
DiPho_devboard/DiPho_devboard.PcbDoc
DiPho_devboard/DiPho_devboard.PrjPcb
DiPho_devboard/DiPho_devboard.SchDoc
DiPho_digital/b2b_connector.SchDoc
DiPho_digital/DiPho_digital.PcbDoc
DiPho_digital/DiPho_digital.PrjPcb
DiPho_digital/DiPho_digital.SchDoc
DiPho_digital/ethernet.SchDoc
DiPho_digital/mcu.SchDoc
DiPho_lib.PcbLib
DiPho_lib.SchLib
libraries.SchLib
production/DiPho_production.PcbDoc
