sinara-hw/DiPho/DiPho_digital/v3.ioc

Mcu.UserName=STM32L452CCUx
PA0.Signal=ADCx_IN5
PA1.Signal=ADCx_IN6
PA10.Signal=I2C1_SDA
PA11.Signal=USB_DM
PA12.Signal=USB_DP
PA4.Signal=COMP_DAC11_group
PA8.Signal=GPIO_Input
PA9.Signal=I2C1_SCL
PB11.Signal=GPIO_Output
PB12.Signal=GPIO_Output
PB13.Signal=GPIO_Output
PB14.Signal=GPIO_Input
PB5.Signal=SPI3_MOSI
PB6.Signal=GPIO_Input
PB7.Signal=GPIO_Output
PB8.Signal=GPIO_Output
PB9.Signal=GPIO_Output
PC13.Signal=GPIO_Output
