sinara-hw/DiPho/(commit log)

2021-03-31 first revision of schematics for afe and mcu boards
    [DiPho_analog.PrjPcb, DiPho_digital.PrjPcb, analog.PcbDoc, analog.SchDoc, ethernet.SchDoc, mcu.SchDoc]
2021-05-07 small update
    [DiPho_analog.PrjPcb, DiPho_digital.PrjPcb]
2021-08-04 changed TIA opamp type, removed unnecessary ports
    [analog.SchDoc, ethernet.SchDoc, mcu.SchDoc]
2021-08-05 draft digital board placement done
    [DiPho_digital.PrjPcb, digital.PcbDoc, ethernet.SchDoc, mcu.SchDoc]
2021-10-10 created analog pcb, draft placement in progress
    [DiPho_analog.PrjPcb, DiPho_digital.PrjPcb, analog.PcbDoc, analog.SchDoc, digital.PcbDoc]
2021-10-12 placement done
    [analog.PcbDoc]
2021-10-23 completed assembly variants for afe board, fixed swapped USB pins on mcu board
    [DiPho_analog.PrjPcb, analog.PcbDoc, analog.SchDoc, mcu.SchDoc]
2021-10-23 fixed wrong op-amp connections
    [analog.SchDoc]
2021-10-26 changed KSZ package to TQFP, replaced F072 with F078, fixed minor mistakes, changed most components source to cern db libraries
    [DiPho_digital.PrjPcb, analog.SchDoc, digital.PcbDoc, ethernet.SchDoc, mcu.SchDoc]
2021-10-26 digital pcb draft placement done
    [digital.PcbDoc, ethernet.SchDoc]
2021-11-01 changed STM power supply to 1.8V only, fixed wrong KSZ interface (SPI -> 8bit parallel), routed all signals but power on digital board
    [digital.PcbDoc, ethernet.SchDoc, mcu.SchDoc]
2021-11-18 updated b2b connector pinout, routed remaining signals
    [analog.PcbDoc, analog.SchDoc]
2021-11-19 digital.PcbDoc routing almost done
    [digital.PcbDoc]
2021-11-19 created PoE adapter project
    [DiPho_adapter.PrjPcb, adapter.PcbDoc, adapter.SchDoc]
2021-11-20 adapter.PcbDoc almost finished
    [adapter.PcbDoc, adapter.SchDoc]
2021-11-27 fixed all issues mentioned in issue #10 + routing almost done
    [DiPho_PoE_adapter.PcbDoc, DiPho_PoE_adapter.PrjPcb, DiPho_PoE_adapter.SchDoc, adapter.PcbDoc, adapter.SchDoc]
2021-11-29 minor fixes in schematic
    [DiPho_PoE_adapter.SchDoc]
2021-11-29 changed schematic style to hierarchical, changed mcu to F103TBU, changed KSZ version to QFN, removed 1V8 supply, added external DAC
    [b2b_connector.SchDoc, digital.SchDoc, ethernet.SchDoc, mcu.SchDoc]
2021-12-01 added missing schematic sheets to .PrjPcb
    [DiPho_digital.PrjPcb, digital.PcbDoc, mcu.SchDoc]
2021-12-01 changed project structure to hierarchical
    [DiPho_analog.PrjPcb, analog.SchDoc, b2b_connector.SchDoc, log.SchDoc, tia.SchDoc]
2021-12-01 fixed all schematic issues mentioned in #10
    [DiPho_analog.PrjPcb, analog.SchDoc, b2b_connector.SchDoc, log.SchDoc, tia.SchDoc]
2021-12-05 changed b2b connector to Molex SlimStack, component placement done, differential pairs routing done
    [DiPho_digital.PrjPcb, b2b_connector.SchDoc, digital.PcbDoc, ethernet.SchDoc, mcu.SchDoc]
2021-12-07 analog board placement done
    [analog.PcbDoc, analog.SchDoc, b2b_connector.SchDoc]
2021-12-09 routing main signals done
    [DiPho_analog.PrjPcb, analog.PcbDoc, analog.SchDoc, b2b_connector.SchDoc]
2021-12-12 finished routing all connections but power nets
    [analog.PcbDoc]
2021-12-12 routing signals almost done
    [DiPho_digital.PrjPcb, digital.PcbDoc, mcu.SchDoc]
2021-12-14 routing all signals done
    [digital.PcbDoc]
2021-12-16 AFE PCB finished, ready to review
    [DiPho_AFE.PcbDoc, DiPho_analog.PrjPcb, analog.PcbDoc, analog.SchDoc, b2b_connector.SchDoc, log.SchDoc]
2021-12-18 fixed drc errors and issues mentioned in #10
    [DiPho_AFE.PcbDoc, DiPho_analog.PrjPcb]
2021-12-18 finished all connections, fixed all issues mentioned in #10, cleared all DRC errors
    [DiPho_digital.PcbDoc, DiPho_digital.PrjPcb, digital.PcbDoc]
2021-12-18 updated readme, renamed several files to be more cohesive
    [DiPho_AFE.PcbDoc, DiPho_AFE.PrjPcb, DiPho_AFE.SchDoc, DiPho_PoE_adapter.PcbDoc, DiPho_PoE_adapter.PrjPcb, DiPho_PoE_adapter.SchDoc, DiPho_digital.PrjPcb, DiPho_digital.SchDoc]
2022-01-10 final changes before manufacturing
    [DiPho_AFE.PcbDoc, DiPho_PoE_adapter.PcbDoc, DiPho_digital.PcbDoc, DiPho_digital.PrjPcb, DiPho_production.PcbDoc]
2022-01-30 final changes before release
    [DiPho_AFE.PrjPcb, DiPho_PoE_adapter.PrjPcb, DiPho_PoE_adapter.SchDoc, DiPho_digital.PcbDoc, DiPho_digital.PrjPcb, DiPho_production.PcbDoc, b2b_connector.SchDoc, ethernet.SchDoc]
2022-01-30 first release commit
    [DiPho_AFE.PcbDoc, DiPho_AFE.PrjPcb, DiPho_AFE.SchDoc, DiPho_PoE_adapter.SchDoc, DiPho_digital.PcbDoc, DiPho_digital.PrjPcb, DiPho_digital.SchDoc, b2b_connector.SchDoc]
2022-10-17 initial changes on v2 revision
    initial changes on v2 revision
    sch: changed tia mux, opamp types
    pcb: completely new tia layout
    [DiPho_AFE.PcbDoc, DiPho_AFE.PrjPcb, DiPho_AFE.SchDoc, DiPho_lib.PcbLib, DiPho_lib.SchLib, b2b_connector.SchDoc, libraries.SchLib, tia.SchDoc]
2022-10-21 v2 afe almost finished
    placement done, 95% traces routed
    [DiPho_AFE.PcbDoc, DiPho_AFE.SchDoc, DiPho_digital.PrjPcb, DiPho_lib.PcbLib, DiPho_lib.SchLib, b2b_connector.SchDoc, tia.SchDoc]
2022-11-07 v2 changes on mcu board
    not completed yet
    [DiPho_AFE.PcbDoc, DiPho_AFE.SchDoc, DiPho_digital.PcbDoc, DiPho_digital.PrjPcb, DiPho_lib.PcbLib, DiPho_lib.SchLib, ethernet.SchDoc, mcu.SchDoc]
2022-11-12 few major changes in schematic, initial PCB placement
    [DiPho_AFE.PrjPcb, DiPho_digital.PcbDoc, DiPho_digital.PrjPcb, DiPho_digital.SchDoc, DiPho_lib.PcbLib, DiPho_lib.SchLib, b2b_connector.SchDoc, ethernet.SchDoc]
2022-11-13 some schematic changes, placement in progress
    [DiPho_digital.PcbDoc, DiPho_digital.SchDoc, DiPho_lib.PcbLib, DiPho_lib.SchLib, b2b_connector.SchDoc, ethernet.SchDoc, mcu.SchDoc]
2022-11-15 small placement changes
    [DiPho_digital.PcbDoc]
2022-11-16 placement almost finished, routing in progress
    [DiPho_digital.PcbDoc, ethernet.SchDoc, mcu.SchDoc]
2022-11-20 small fix in one symbol
    [DiPho_lib.SchLib]
2022-11-20 placement done, routing in progress
    [DiPho_digital.PcbDoc, b2b_connector.SchDoc, ethernet.SchDoc, mcu.SchDoc]
2022-11-22 routing almost finished
    [DiPho_digital.PcbDoc]
2022-11-27 small updates to pcb
    [DiPho_digital.PcbDoc]
2022-11-27 routing in progress - almost finished
    [DiPho_digital.PcbDoc, DiPho_digital.SchDoc, b2b_connector.SchDoc, ethernet.SchDoc, mcu.SchDoc]
2022-11-28 routing finished, checked MBA for collisions
    [DiPho_digital.PcbDoc, DiPho_digital.PrjPcb]
2022-12-01 all boards finished, new devboard designed
    [DiPho_AFE.PcbDoc, DiPho_AFE.PrjPcb, DiPho_devboard.PcbDoc, DiPho_devboard.PrjPcb, DiPho_devboard.SchDoc, DiPho_digital.PcbDoc, DiPho_digital.PrjPcb, DiPho_lib.PcbLib]
2022-12-01 fixed small clearance issues
    [DiPho_devboard.PcbDoc]
2022-12-06 added power supply header to devboard
    [DiPho_devboard.PcbDoc, DiPho_devboard.SchDoc]
2022-12-23 removed PoE_adapter from this revision
    [DiPho_PoE_adapter.PcbDoc, DiPho_PoE_adapter.PrjPcb, DiPho_PoE_adapter.SchDoc]
2022-12-23 fixed few issues in MCU board
    [DiPho_digital.PrjPcb, ethernet.SchDoc]
2022-12-23 minor fixes in AFE board
    [DiPho_AFE.PrjPcb, DiPho_AFE.SchDoc, tia.SchDoc]
2023-01-07 fabrication and assembly files generated for all projects
    [DiPho_AFE_BoM.xlsx, DiPho_digital_BoM.xlsx]
